LPerezBustos/EC3883_AutomaticGuidedVehicle/final-report/images/3_front.jpg

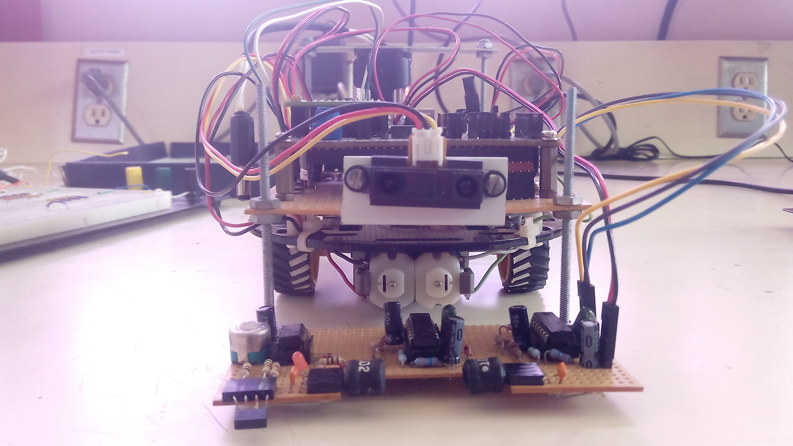
final-report/images/3_front.jpg
