LPerezBustos/EC3883_AutomaticGuidedVehicle/final-report/images/4_side.jpg

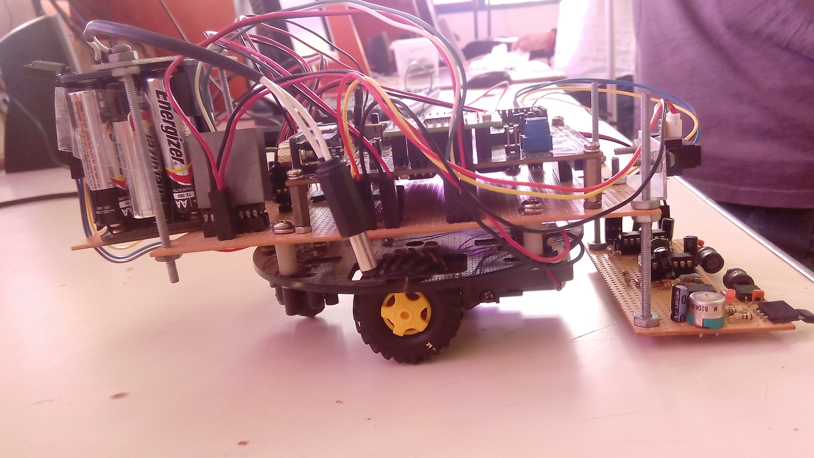
final-report/images/4_side.jpg
