LPerezBustos/EC3883_AutomaticGuidedVehicle/README.md

# Automatic Guided Vehicle for EC3883 coursework
