LPerezBustos/EC3883_AutomaticGuidedVehicle/final-report/Anteproyecto.pdf

# Propuesta de Proyecto - Grupo I Sistema de Vehículo Autónomo con Control de Tráfico

Bernardo Aceituno-C, Alejandro Meilan, Luis Pérez Bustos, Carlos Luis.

## 1. Introducción

Esta propuesta presenta una primera aproximación del proyecto a realizar dentro de la asignatura EC3883. Se dispone de 12 semanas a partir del 09 de enero de 2017 para su realización. Se utilizan principalmente los componentes dispuestos en el Laboratorio C de la Universidad Simón Bolívar más ciertos adicionales adquiridos personalemente. Los Profesores Carlos Morón y Guillermo Villegas se encargarán de monitorear el buen desarrollo del proyecto. Se deben entregar, periodicamente, demostraciones que validen el cumplimiento del plan de trabajo.

## 2. Proyecto

### 2.1. Objetivo General

Realizar vehículo autoguíado (AGV) por detección de señal electromagnética con algortimos de planificación de trayectoria y detección de obstáculos a través de una cámara central.

### 2.2. Objetivos Específicos

1. Configurar funcionamiento de los motores con control PWM a través del driver L293D.
2. Desarrollar circuito de adquisición y acondicionamiento de señal electromagnética para mantener el vehículo en línea recta.
3. Detectar e implementar lógica de toma de decisiones frente a señales de cruce.
4. Detectar obstáculos que se encuentren a cierto rango de distancia e implementar lógica de toma de decisiones.
5. Diseñar algoritmo que controle los movimientos del vehículo a través de una camara web para evitar colisiones con obstáculos u otros vehículos que se encuentren simultáneamente en la cuadrilla.
6. Desarrollar protocolo de comunicación infraroja entre el computador y el vehículo.

### 2.3. Etapas

Para detallar el funcionamiento esperado del proyecto a desarollar se dividió a este en las siguientes etapas.

adquisición y acondicionamiento de señal electromagnética

control PWM de los motores

detección de señal de cruce

detección de obstáculos

mapeado de la cuadrilla

algortimo de planificación

protocolo de comunicación

### 2.4. Representación General

El diagrama de la Figura 1 ilustra el esquema general del proyecto. Se observa el funcionamiento en conjunto de las etapas descritas con anterioridad.

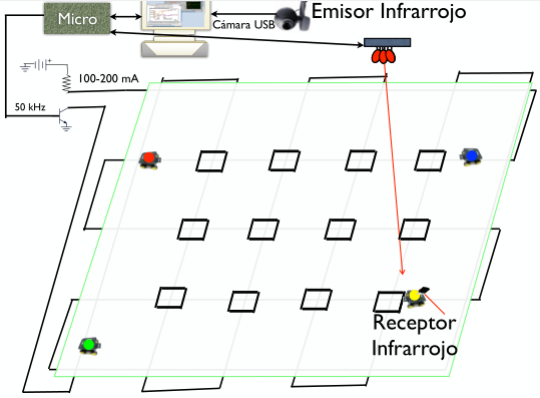
[picture p3: figure]

Figura 1: Esquema general del Proyecto

## 3. Plan de Trabajo:

Se presenta a continuación el plan de trabajo tentativo programado para ser desarrollado a lo largo del trimestre en curso:

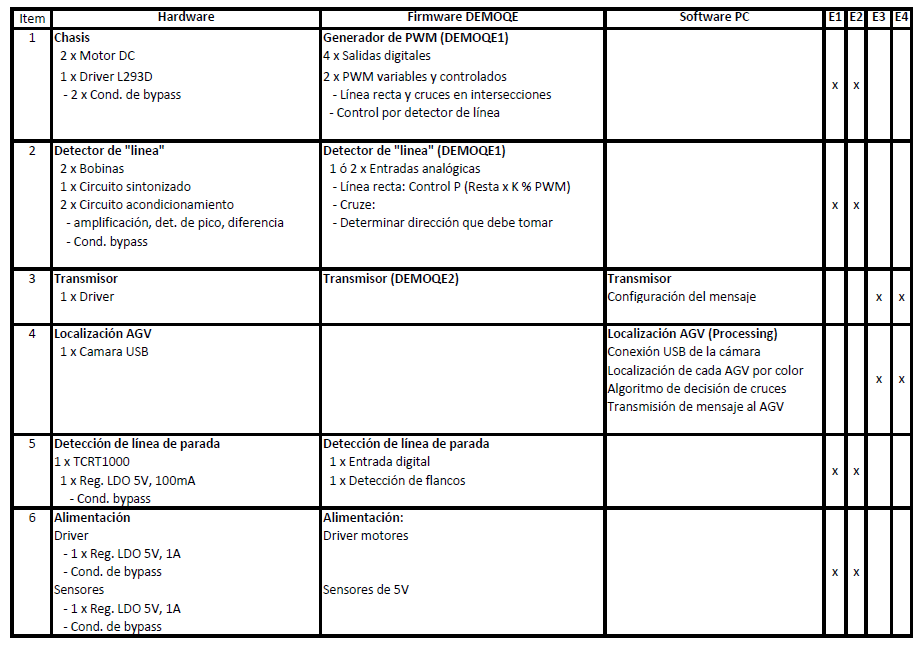
[picture p4: figure]

Figura 2: Distribución de tareas

Tabla 1: Plan de trabajo tentativo
Semana 2 | Revisión bibliográfica y familiari-zación con el entorno de trabajo | Revisión de los circuitos de acon-dicionamiento de señales y dri-vers de sensores
Semana 3 | Diseño e Implementación de sis-tema de detección de vehículos | Montaje en Protoboard del acon-dicionamiento de bobinas, driver de motores, detector de línea y detector de obstáculos
Semana 4 | Pruebas de sistema de detección de vehículos y Mapeo de Pista | Desarrollo del software para ge-neración de señales PWM en ba-se a la señal de las bobinas. Primeras pruebas del sistema de control.
Semana 5 | Pruebas de Mapeo de Pista, Co-municación PC-MCU y Planifi-cacion de Camino y toma de de-cisiones | Incorporación de la detección de línea en algoritmo de contro. Prueba con T para realizar un gi-ro.
Semana 6 | Pruebas de Comunicación, Deci-siones y Planificación, Desarro-llo de Protocolo de Comunica-ción infrarroja | Incorporación de la detección de obstáculos al algoritmo de con-trol.
Semana 7 | Pruebas de Comunicación | Toma de decisiones en base a las señales recibidas desde el PC via IR. Pruebas de comunicación
Semana 8 | Integración con Vehiculo, Imple-mentación de Pista | Soldar circuitos a baquelita y construcción final del carro.
Semana 9 | Pruebas de Funcionamiento de Vehiculo
Semana 10 | Pruebas de Funcionamiento de Vehiculo
Semana 11 | Entrega del proyecto

## 4. Circuitos

A continuación se presentan los circuitos propuestos para el acondimiento de señales y alimentación de distintos tipos de sensores y actuadores.

### 4.1. Fuentes de Voltaje

Se requieren dos fuentes de voltaje para el proyecto: una para alimentar los motores DC del vehículo y una para alimentar el resto de los sensores. Ambas fuentes se presentan en la Figura 3

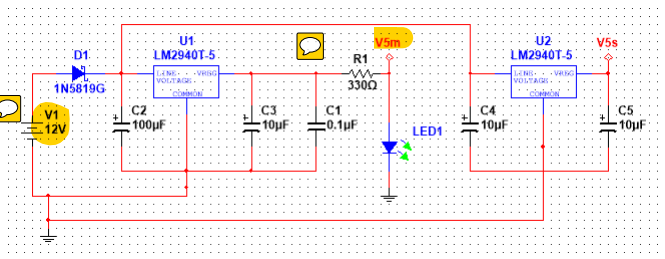
[picture p5: figure]

Figura 3: Fuentes de voltaje DC 5V

La señal V5m corresponde a la alimentación de los motores y la señal V5s a la alimentación de los sensores. En ambos casos se utiliza el integrado LM2940-5 que es un regulador de 5V DC. La entrada de 12V proviene del conector DC del mesón, y se utiliza un diodo rectificador Schottky de protección. En ambas fuentes se utilizan capacitores electrolíticos de bypass, y para la fuente del motor se añade tambien un capacitor cerámico extra para asegurar una alimentación libre de ruido. El LED sirve para verificar en todo momento la correcta alimentación de los motores.

### 4.2. Acondicionamiento de las bobinas

Para este circuito se presentan dos propuestas similares, y a través de simulaciones se determinó cual de ellas era preferible dada la naturaleza del proyecto.

Propuesta 1: el circuito de la Figura 4 es la primera propuesta para acondicionar la señal proveniente de las bobinas.

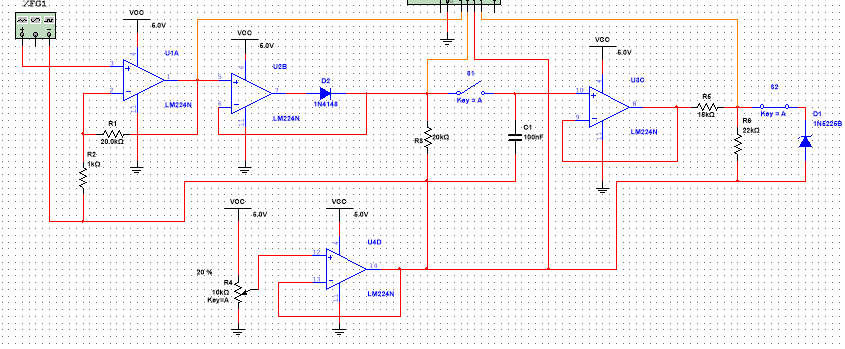
[picture p6: figure]

Figura 4: Acondicionamiento de bobinas - Propuesta 1

Del lado izquierdo hay una primera etapa de amplificación de la señal, con una ganancia de 20 y con una tierra virtual implementada con el seguidor de la parte de abajo, cuya salida de voltaje se maneja con el potenciómetro R4. Seguido de esta etapa de amplificación hay un rectificador de media onda utilizando el diodo 1N4148. La tercera etapa de la adquisición es un detector de pico, para el cual se escogió una combinación de resistencia y capacitor en simulación que otorgara una respuesta adecuada. El buffer de la última etapa se coloca para aislar la salida de las impedancias del resto del circuito, ya que esta salida entrará al microcontrolador. Se coloca un divisor de tensión y un diodo Zener de 3V para proteger al microcontrolador. Los valores del divisor de tensión deberán ser ajustados en práctica dependiendo de las salidas máximas y mínimas de las bobinas.

Se simuló el canal de adquisión con una señal sinusoidal de 50KHz y 50mVp que hiciera las veces de la señal de la bobina. Primero se levantó el switch A para observar la señal del rectificador de media onda (CH2), como se presenta en la Figura 5

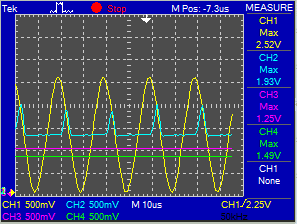
[picture p7: figure]

Figura 5: Amplificador (CH1), Rectificador sin detector de pico (CH2), tierra virtual (CH3), salida final (CH4)

Se observa que la rectificación con un solo diodo no es perfecta, principalmente por las frecuencias a las que se está trabajando. Internamente el diodo presenta retardos respecto a la frecuencia de trabajo de las bobinas que impiden que la rectificación sea mejor. Al bajar el switch se observa en la Figura 6 la respuesta del rectificador con detector de picos en el canal 2.

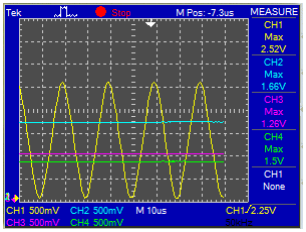
[picture p8: figure]

Figura 6: Amplificador (CH1), Rectificador con detector de pico (CH2), tierra virtual (CH3), salida final (CH4)

Utilizando una tierra virtual de 1.25V, se observa que se levanta el nivel DC de la señal amplificada de la bobina y se elimina la componente negativa de la misma. En el canal 2 se muestra la salida del rectificador con detector de pico, que logra un nivel DC de 1.64V. Finalmente, la señal que entrara al microcontrolador es una DC de 1.48V que es proporcional a la intensidad de campo sobre la bobina.

Propuesta 2: la segunda propuesta para el acondicionamiento de las bobinas se muestra en la Figura 7:

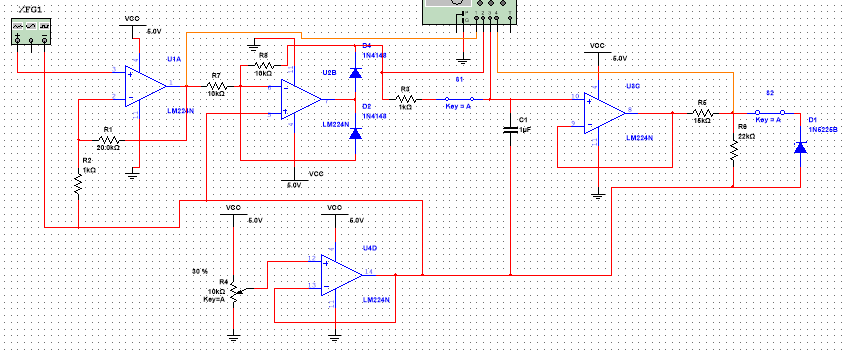
[picture p9: figure]

Figura 7: Acondicionamiento de bobinas - Propuesta 2

La diferencia respecto a la primera propuesta es el circuito rectificador, que en este caso se hace con dos diodos y se trata de de un rectificador de media onda negativa. Después del rectificador se sustituyó el circuito de detección de picos por un filtro pasabajo con frencuencia de corte 1/RC = 1000rad/s = 159,15Hz. Este nuevo circuito de rectificación otorgó mejores resultados que en el caso anterior, como muestra la Figura 8:

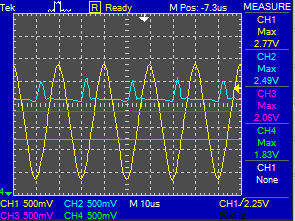
[picture p10: figure]

Figura 8: Amplificador (CH1), Rectificador (CH2), Filtro pasabajo (CH3), Salida final (CH4)

La señal del canal 2 muestra la salida del rectificador, que al compararla con la señal obtenida con la primera propuesta se nota que presenta una respuesta más adecuada, con menos retardos en la señal rectificada. El valor de voltaje de la salida del canal de adquisición es mayor gracias a la rectificación mejorada, por lo que esta propuesta es la que se implementará en el proyecto.

### 4.3. Driver de los motores

Para controlar los motores se utilizan señales PWM, utilizando el driver de motores L293D, tal como se muestra en la Figura 9:

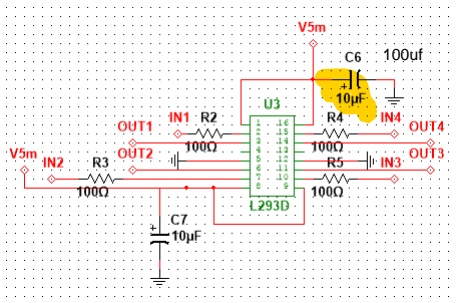
[picture p11: figure]

Figura 9: Driver de motores

Las entradas INx van al microcontrolador, a partir del cual se envian 1s y 0s lógicos para crear las señales cuadradas del PWM. Las salidas OUTx irán conectadas a los motores. El control del ancho de pulso se hace también desde el microcontrolador y será la salida del controlador a implementar para que el vehículo siga la línea, según las lecturas de las bobinas.

### 4.4. Detección de Obstáculos

Con el objetivo de detectar objetos que obstruyan el camino de vehículo autoguíado, se utiliza el sensor de distancia por emisión infraroja Sharp GP2Y0A21YK. El objetivo es incorporar una nueva primititiva que permita al vehículo tomar decisiones adecuadas de acuerdo a su entorno. La Figura 10 muestra el modelo comercial del cual se dispone en el laboratorio C. Las características eléctricas del dispositivo se listan a continuación:

Vcc: 4,5V a +5,5V

Rango de distancias: 10cm a 80cm

Vo @ L=80cm: 0,25V a 0,55V

Icc @ L=80cm: 30mA a 40mA

Vo(@L=10cm) - Vo(@L=80cm): 1,65V a 2,15V

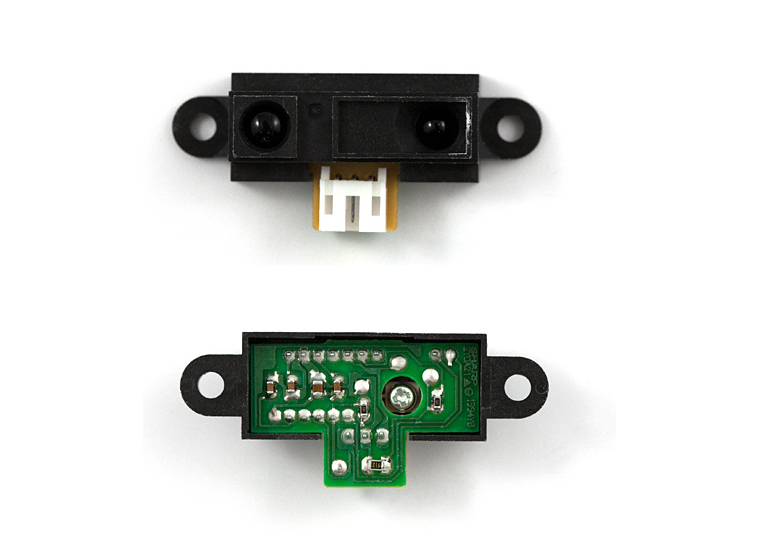
[picture p12: figure]

Figura 10: Sensor de proximidad Sharp GP2Y0A21YK

La Figura 11 ilustra la respuesta del sensor en su rango de funcionamiento correspondiente. Se observa un máximo entre 5cm y 10cm con una respuesta aproximadamente lineal hasta 30cm.

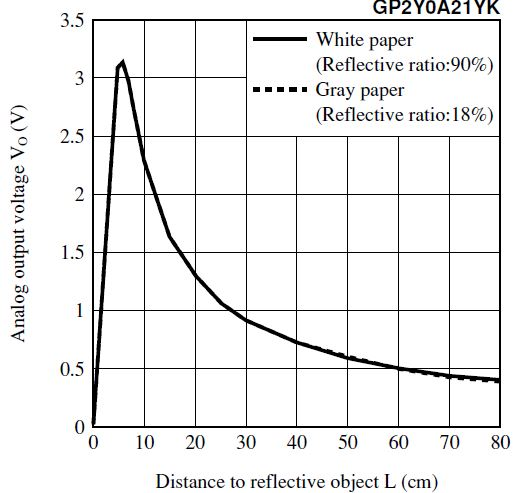
[picture p13: figure]

Figura 11: Relación Vo (V) vs. distancia (cm)

El funcionamiento del sensor GP2Y0A21YK se observa en la Figura 12. El detector infrarojo situado a la derecha del sensor recibe la señal reflejada desde una cierta superficie y enfocada a través del lente. El circuito interno del sensor permite arrojar una señal que sigue el patrón de la Figura 11.

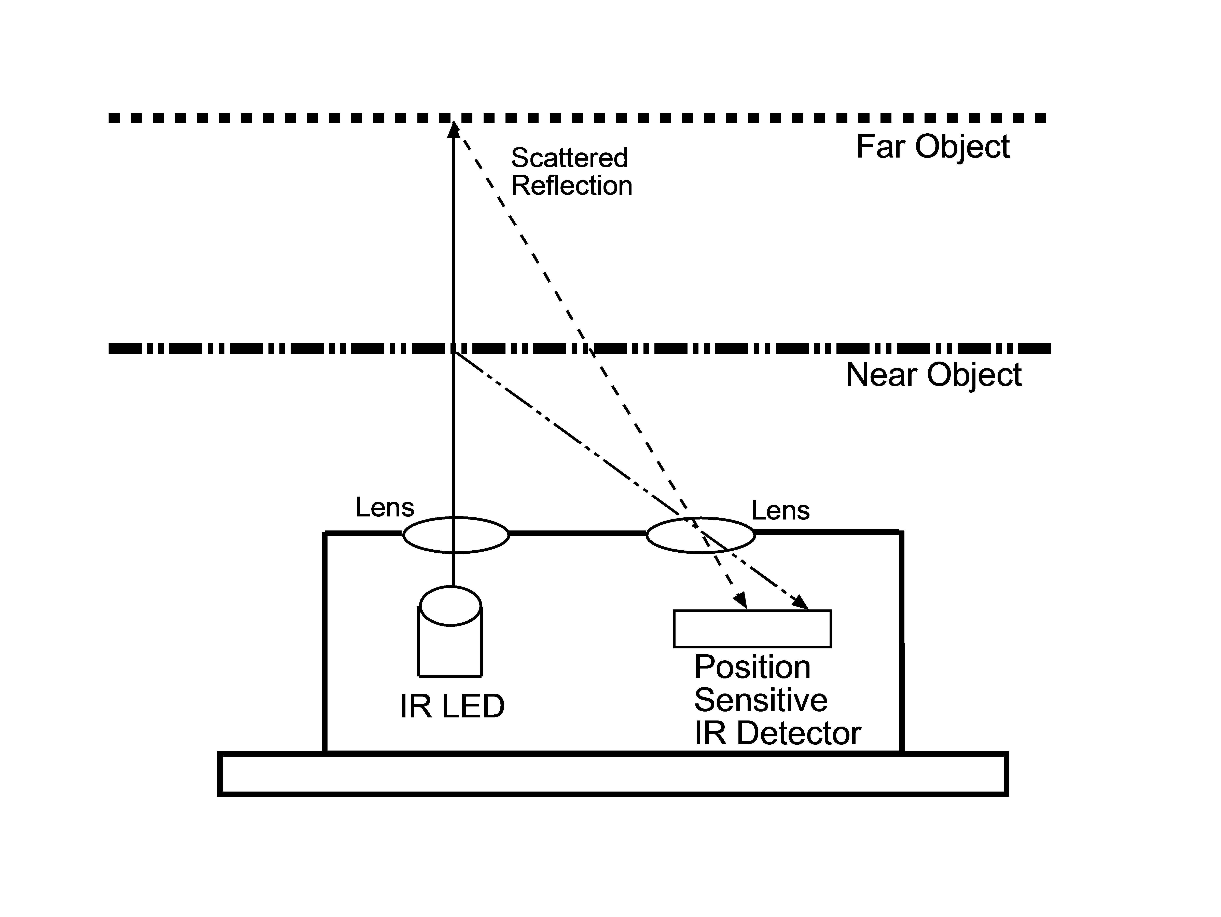
[picture p14: figure]

Figura 12: Funcionamiento del sensor de proximidad

Para adquirir la señal deseada desde el demoQE128, se acondiciona la señal utilizando el circuito de la Figura 13. Se utiliza la segunda etapa del circuito para reducir el nivel de voltaje en un 60 % y evitar máximos que sobrepasen los límites del micro-controlador.

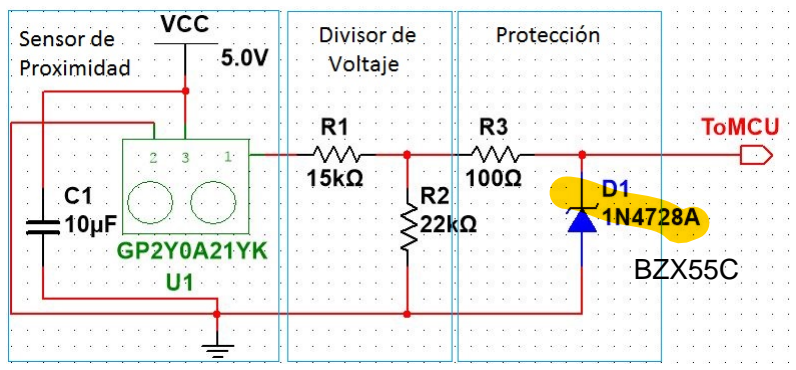
[picture p15: figure]

Figura 13: Circuito de adquisición y acondicionamiento

### 4.5. Detección de Señal de Cruce

A la lógica del vehículo autoguíado se añade la detección de señales de cruce colocadas en las intersecciones de la cuadrilla. Se han de fijar marcas oscuras en dichos lugares. Para su adecuada detección se utiliza el sensor óptico TCRT1000 de la Figura 14. Es un sensor reflectivo que incluye un emisor infrarojo y un fototransistor en un mismo empaquetado sellado que bloquea la luz visible.

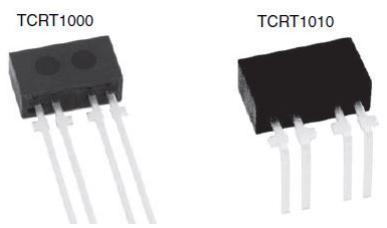
[picture p16: figure]

Figura 14: Sensor óptico TCRT1000

Las dimensiones del módulo se observan en la Figura 15.

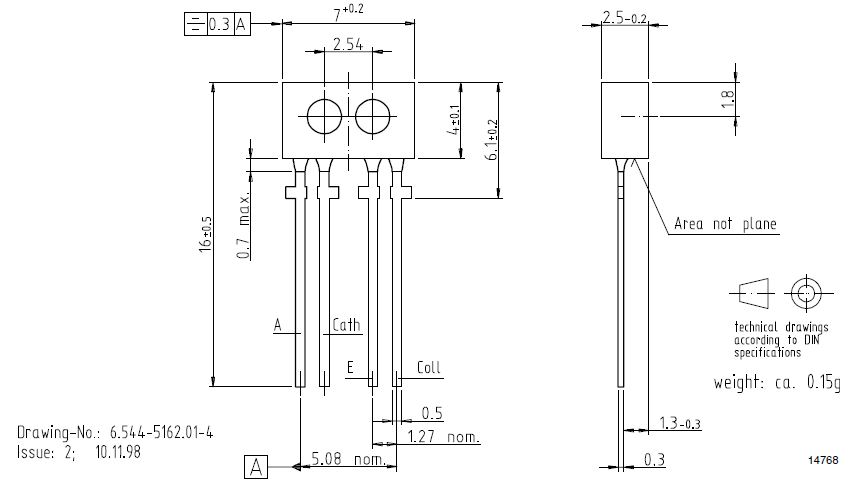
[picture p17: figure]

Figura 15: Dimensiones del sensor óptico TCRT1000

El emisor genera luz infraroja de hasta 940nm que es reflejada (o no) por la superficie correspondiente. La salida detecta esta luz y se habilita (o no) el paso de corriente de colector a emisor. La Figura 16 ilustra el funcionamiento.

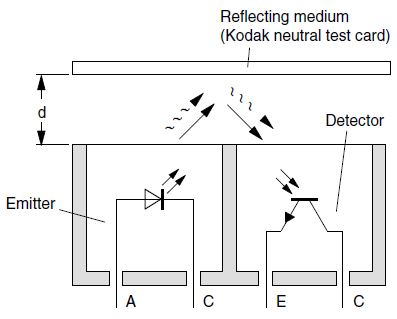
[picture p18: figure]

Figura 16: Funcionamiento del sensor óptico

Se añade el circuito de acondicionamiento de la Figura 17. La salida del TCRT1000 es a través de una resistencia pull-up que se conecta directamente al comparador LM311. La salida de este módulo depende de la diferencia de voltajes entre los pines 2 y 3. En la entrada inversora se fija un cierto voltaje de threshold con el cual se comparará la señal de la entrada no-inversora. Los niveles de tensión posibles estarán entre el %60 de Vcc ( 3V) y el voltaje fijado en el pin 1 (GND). Se añade una etapa de protección como parte final del circuito.

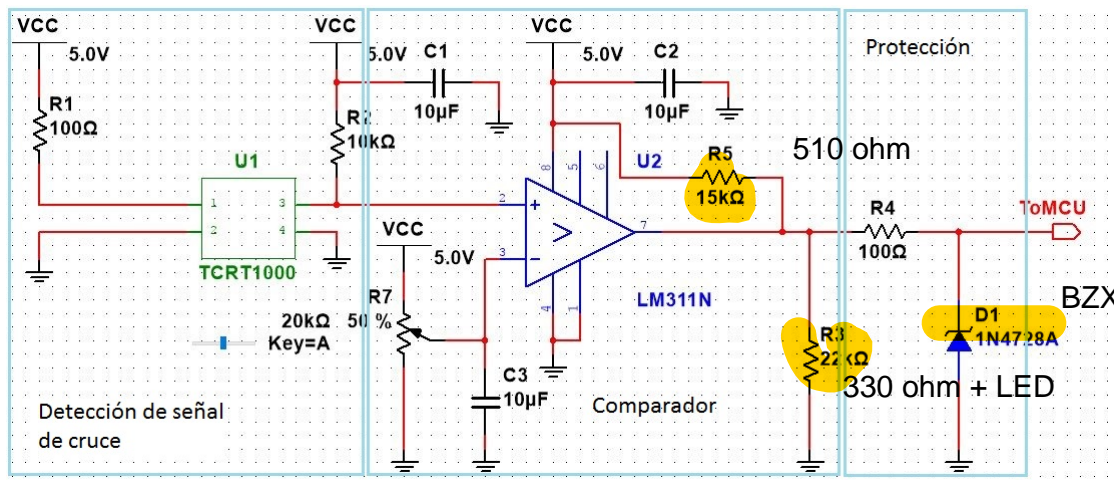
[picture p19: figure]

Figura 17: Circuito de adquisición y acondicionamiento

### 4.6. Circuito Seguidor de Línea

Esta configuración será utilizada para acondicionar la línea de pista por la cual se desplazará el vehiculo. Consiste básicamente en obtener una señal desde el microcontrolador (onda cuadrada de 3V @50kHz) y pasarlo por un circuito emisor común. De esta forma la señal que debe seguir el carro a través de la bobinas estará correctamente acondicionada. Un esquematico del circuito es mostrado en la Figura 18.

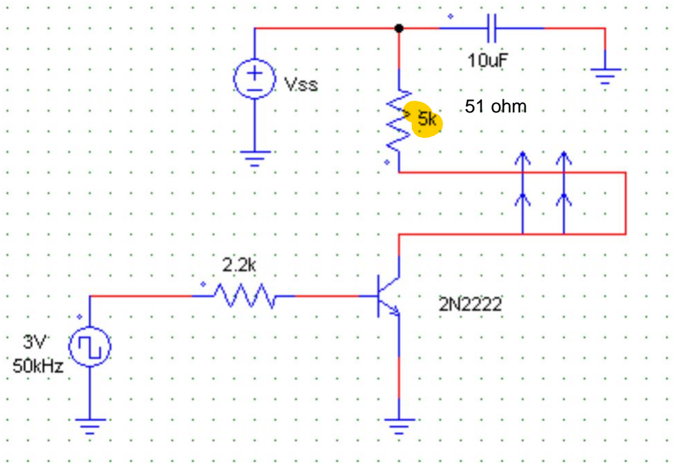
[picture p20: figure]

Figura 18: circuito Seguidor de Línea

### 4.7. Circuito Transmisión Infrarroja – Vehiculo / Mesón

Estas dos configuraciones son necesarias para acondicionar la transmisión infrarroja entre el carrito y el mesón. La primera consiste en un TSOP1136 protegido con un diodo zener de 3 voltios y una resistencia. El segundo es un circuito emisor común con un capacitor y un diodo en inverso. Ambas configuraciones son necesarias para la transmisión infrarroja entre los dispositivos. Estos circuitos mostrados en las figuras Figura 19 y Figura 20.

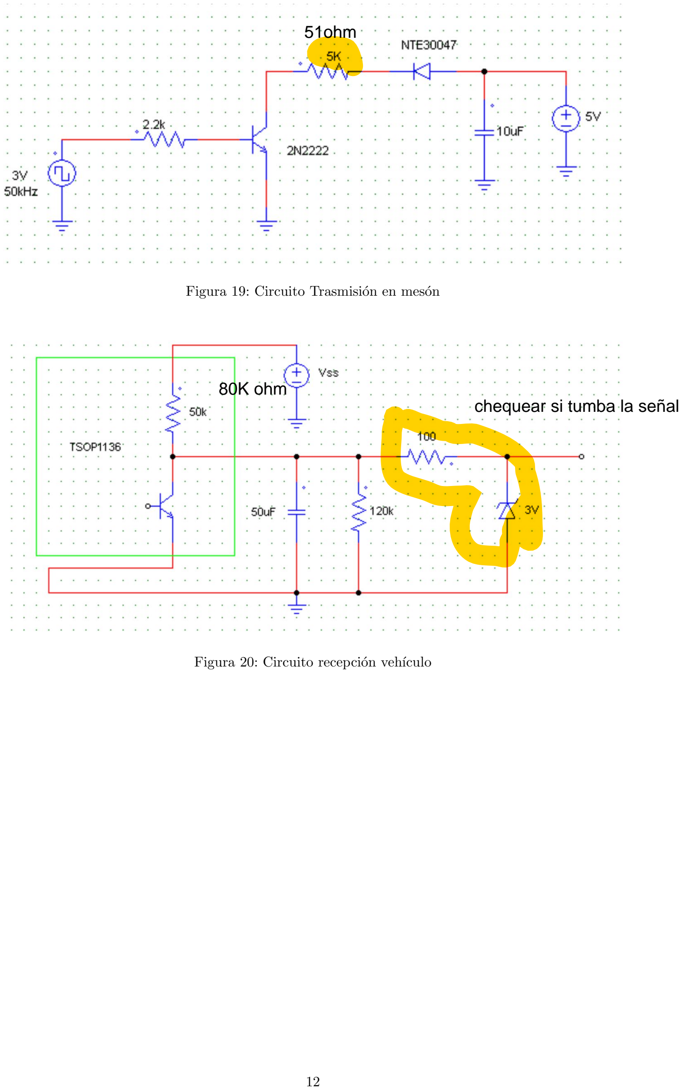
[picture p21: page 12]

Figura 19: Circuito Trasmisión en mesón

Figura 20: Circuito recepción vehículo

## 5. Arquitectura Software

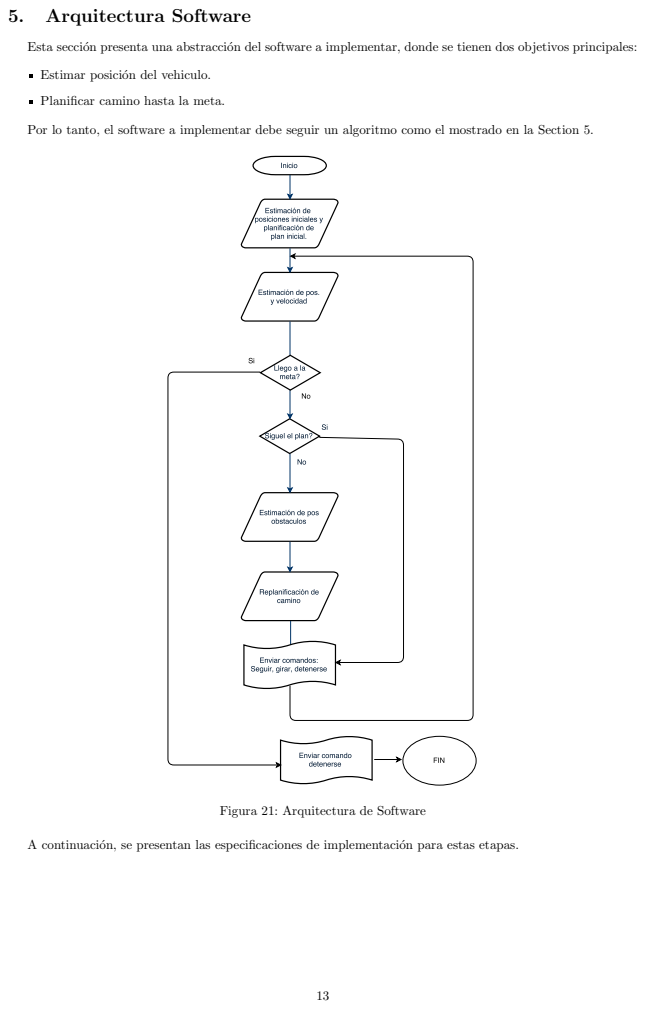
[picture p22: page 13]

Esta sección presenta una abstracción del software a implementar, donde se tienen dos objetivos principales:

Estimar posición del vehiculo.

Planificar camino hasta la meta.

Por lo tanto, el software a implementar debe seguir un algoritmo como el mostrado en la Section 5.

Figura 21: Arquitectura de Software

A continuación, se presentan las especificaciones de implementación para estas etapas.

### 5.1. Visión

La etapa de visión poro computadora será desarrollada en Python 3.5.0 bajo la librería OpenCV 3, dicha librería ofrece las siguientes funcionalidades de interés:

1. Interfaz con camara de video.
2. Extracción de fondo de imagen.
3. Estimación de posición de objetos.

En particular resultan de interes las funciones presentadas en la tabla Tabla 2

Tabla 2: Funciones de interés para la etapa de visión
inRange | Extrae los pixeles en un color de la imagen dada
erode | Elimina residuos de la extraccion de mascara del objeto
dilate | Dilata la mascara obtenida para reducción de ruido
findContours | calcula el contorno de las formas presentes en la máscara
minEnclosingCircle | Obtiene el radio y el centro del circulo presente en la máscara

### 5.2. Planificación

La planificación a implementar será basada en teoria de grafos, sobre una versión discretizada del espacio de trabajo. Para ello se va a implementar una libreria de grafos sobre Python 3.0 con los siguientes objetivos:

1. Representación de caminos unidireccionales y bidireccionales.
2. Representación de heuristicas admisibles basadas en distancia.
3. Inhabilitación de caminos.
4. planificación de caminos basada en busquedas discretas con heuristica.

Esta ultima etapa resulta de mayor interés para este proyecto, pues debe ser capaz de calcular el cámino mas corto entre dos puntos dados. Para esto resulta de interés el uso del algoritmo de busqueda A*, pues resulta en planes optimos con poca exigencia computacional, como se muestara en la Section 5.2

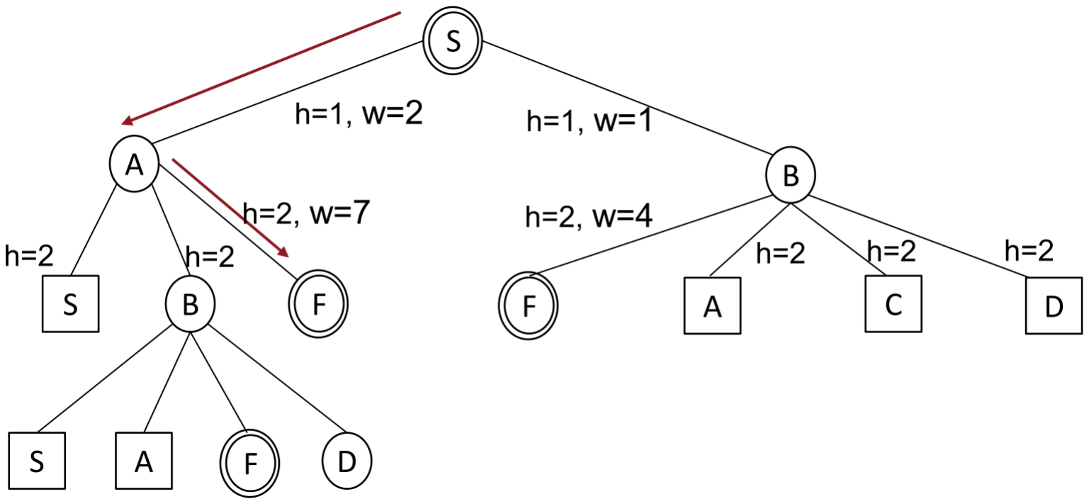
[picture p23: figure]

Figura 22: Interpretación gráfica del algoritmo A*

### 5.3. Comunicación

La comunicación con el microcontrolador se realizara mediante protocolo serial, para ello se puede hacer uso de la libreria serial incluida en Python 3.0 con un protocolo de comunicación binario de instrucciones simples.
