LPerezBustos/EC3883_AutomaticGuidedVehicle/final-report/Informe-Final-EC3883.pdf

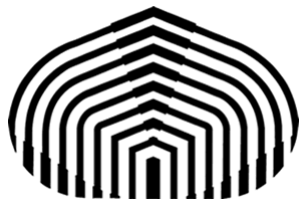
[picture p24: figure]

# Informe de Proyecto Sistema de Vehículo Autoguiado (AGV) con Control de Tráfico

Bernardo Aceituno-C, Alejandro Meilan, Luis Pérez Bustos, Carlos Luis.

## Índice

1. Introducción | 3
2. Estructura del Proyecto | 4
3. Hardware | 5
4. Software | 17

## 1. Introducción

El proyecto asociado a la asignatura EC3883 “Laboratorio de Proyectos III” corresponde a un trabajo grupal que engloba diversas áreas de la electrónica como circuitos analógicos, sistemas embebidos, control y comunicaciones.

El proyecto consiste en diseñar un vehículo autónoma con capacidades de seguimientos de una línea eléctrica y con componentes adicionales de seguridad como detección de líneas de paradas, detección de obstáculos y un controlador de alto nivel que le indica una ruta para llegar a un punto deseado.

En este documento se incluye información concisa sobre la primera propuesta inicial así como detalles de la implementación final del proyecto, con diagramas e imágenes para facilitar su entendimiento al igual que evidencia videográfica de su funcionamiento.

## 2. Estructura del Proyecto

Esta sección presenta una visión general del funcionamiento y la implementación del proyecto.

### 2.1. Objetivo General

Realizar vehículo autoguíado (AGV) por detección de señal electromagnética con algortimos de planificación de trayectoria y detección de obstáculos a través de una cámara central.

### 2.2. Objetivos Específicos

1. Configurar funcionamiento de los motores con control PWM a través del driver L293D.
2. Desarrollar circuito de adquisición y acondicionamiento de señal electromagnética para mantener el vehículo en línea recta.
3. Detectar e implementar lógica de toma de decisiones frente a señales de cruce.
4. Detectar obstáculos que se encuentren a cierto rango de distancia e implementar lógica de toma de decisiones.
5. Diseñar algoritmo que controle los movimientos del vehículo a través de una camara web para evitar colisiones con obstáculos u otros vehículos que se encuentren simultáneamente en la cuadrilla.
6. Desarrollar protocolo de comunicación infraroja entre el computador y el vehículo.

### 2.3. Etapas

Para detallar el funcionamiento esperado del proyecto a desarollar se dividió a este en las siguientes etapas.

1. adquisición y acondicionamiento de señal electromagnética
2. control PWM de los motores
3. detección de señal de cruce
4. mapeado de la cuadrilla
5. algortimo de planificación
6. protocolo de comunicación

### 2.4. Representación General

El diagrama de la Figura 1 ilustra el esquema general del proyecto. Se observa el funcionamiento en conjunto de las etapas descritas con anterioridad.


Figura 1: Esquema general del Proyecto

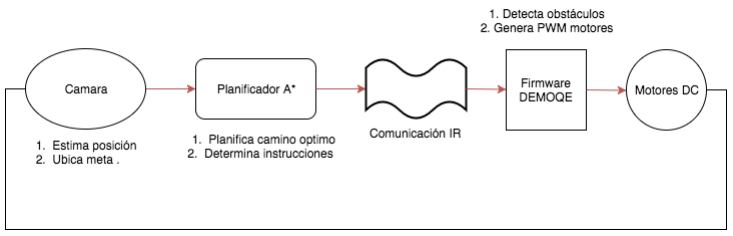
[picture p25: figure]

Figura 2: Diagrama de fucionamiento del sistema

## 3. Hardware

A continuación se presentan los circuitos utilizados para el acondimiento de señales y alimentación de los sensores y actuadores utilizados.

### 3.1. Fuentes de Voltaje

Se utilizaron dos fuentes de voltaje para el proyecto: una para alimentar los motores DC del vehículo y una para alimentar el resto de los sensores. Ambas fuentes se presentan en la Figura 3

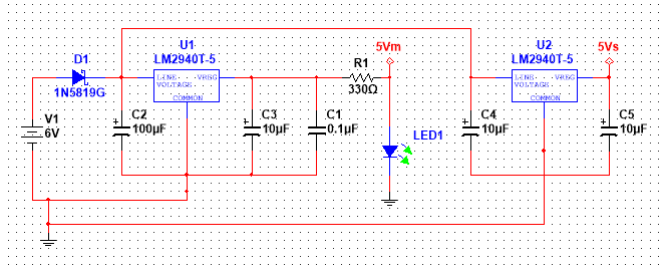
[picture p26: figure]

Figura 3: Fuentes de voltaje DC 5V

La señal V5m corresponde a la alimentación de los motores y la señal V5s a la alimentación de los sensores. En ambos casos se utiliza el integrado LM2940-5 que es un regulador de 5V DC. La entrada de 12V proviene del conector DC del mesón, y se utiliza un diodo rectificador Schottky de protección. En ambas fuentes se utilizan capacitores electrolíticos de bypass, y para la fuente del motor se añade tambien un capacitor cerámico extra para asegurar una alimentación libre de ruido. El LED sirve para verificar en todo momento la correcta alimentación de los motores.

### 3.2. Acondicionamiento de las bobinas

Para este circuito se presentan dos propuestas similares, y a través de simulaciones se determinó cual de ellas era preferible dada la naturaleza del proyecto.

Propuesta 1: el circuito de la Figura 4 es la primera propuesta para acondicionar la señal proveniente de las bobinas.


Figura 4: Acondicionamiento de bobinas - Propuesta 1

Del lado izquierdo hay una primera etapa de amplificación de la señal, con una ganancia de 20 y con una tierra virtual implementada con el seguidor de la parte de abajo, cuya salida de voltaje se maneja con el potenciómetro R4. Seguido de esta etapa de amplificación hay un rectificador de media onda utilizando el diodo 1N4148. La tercera etapa de la adquisición es un detector de pico, para el cual se escogió una combinación de resistencia y capacitor en simulación que otorgara una respuesta adecuada. El buffer de la última etapa se coloca para aislar la salida de las impedancias del resto del circuito, ya que esta salida entrará al microcontrolador. Se coloca un divisor de tensión y un diodo Zener de 3V para proteger al microcontrolador. Los valores del divisor de tensión deberán ser ajustados en práctica dependiendo de las salidas máximas y mínimas de las bobinas.

Se simuló el canal de adquisión con una señal sinusoidal de 50KHz y 50mVp que hiciera las veces de la señal de la bobina. Primero se levantó el switch A para observar la señal del rectificador de media onda (CH2), como se presenta en la Figura 5


Figura 5: Amplificador (CH1), Rectificador sin detector de pico (CH2), tierra virtual (CH3), salida final (CH4)

Se observa que la rectificación con un solo diodo no es perfecta, principalmente por las frecuencias a las que se está trabajando. Internamente el diodo presenta retardos respecto a la frecuencia de trabajo de las bobinas que impiden que la rectificación sea mejor. Al bajar el switch se observa en la Figura 6 la respuesta del rectificador con detector de picos en el canal 2.


Figura 6: Amplificador (CH1), Rectificador con detector de pico (CH2), tierra virtual (CH3), salida final (CH4)

Utilizando una tierra virtual de 1.25V, se observa que se levanta el nivel DC de la señal amplificada de la bobina y se elimina la componente negativa de la misma. En el canal 2 se muestra la salida del rectificador con detector de pico, que logra un nivel DC de 1.64V. Finalmente, la señal que entrara al microcontrolador es una DC de 1.48V que es proporcional a la intensidad de campo sobre la bobina.

Propuesta 2: la segunda propuesta para el acondicionamiento de las bobinas se muestra en la Figura 7:


Figura 7: Acondicionamiento de bobinas - Propuesta 2

La diferencia respecto a la primera propuesta es el circuito rectificador, que en este caso se hace con dos diodos y se trata de un rectificador de media onda negativa. Después del rectificador se sustituyó el circuito de detección de picos por un filtro pasabajo con frencuencia de corte 1/RC = 1000rad/s = 159,15Hz. Este nuevo circuito de rectificación otorgó mejores resultados que en el caso anterior, como muestra la Figura 8:

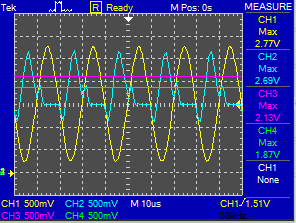
[picture p27: figure]

Figura 8: Amplificador (CH1), Rectificador (CH2), Filtro pasabajo (CH3), Salida final (CH4)

La señal del canal 2 muestra la salida del rectificador, que al compararla con la señal obtenida con la primera propuesta se nota que presenta una respuesta más adecuada, con menos retardos en la señal rectificada. El valor de voltaje de la salida del canal de adquisición es mayor gracias a la rectificación mejorada, por lo que esta propuesta es la que se implementará en el proyecto.

El circuito final implementado es el mostrado en la Figura 9

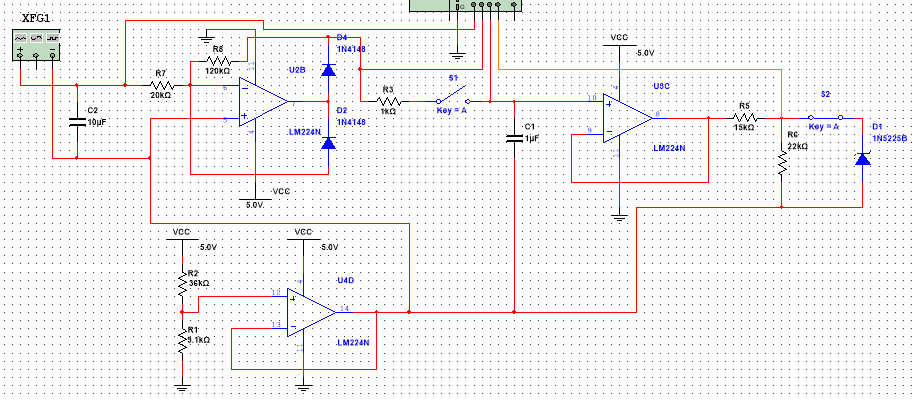
[picture p28: figure]

Figura 9: Circuito final para adquisión de señal de bobinas

Los principales cambios introducidos en la versión final es la eliminación de uno de los operacionales para realizar la etapa de rectificación y amplificación con un sólo opamp, además de reducir la ganancia de 20 a 6 para obtener una máxima excursión en la señal DC obtenida a través del circuito de acondicionamiento. Se sustituyó el potenciómetro que fijaba la tierra virtual por una combinación de resistencias que dio un offset DC de 1V (usando 9.1k y 36k).

La primera acción al montar el circuito fue determinar la frecuencia de resonancia de las bobinas utilizadas, es decir, la frecuencia en la que la amplitud de la onda sinusoidal era máxima, que resultó ser de 56KHz y fue la frecuencia utilizada para excitar estos sensores (utilizando el cable de la pista). Con este circuito se hicieron mediciones con dos casos especiales: la bobina está lejos de la pista, y la bobina está justo encima de la línea elećtrica. En el primero de los casos la salida del circuito de acondicionamiento era directamente el nivel DC de la tierra virtual del sistema (1V), mientras que al estar encima de la línea el voltaje arrojado por la bobina era el máximo posible que resultó ser de 2.88V. Estos datos fueron importantes a la hora de codificar el firmware de control de los motores pues permitía saber a groso modo en qué punto el carro estaba pasando sobre una de las líneas al realizar un giro.

### 3.3. Driver de los motores

Para controlar los motores se utilizan señales PWM, utilizando el driver de motores L293D, tal como se muestra en la Figura 10:

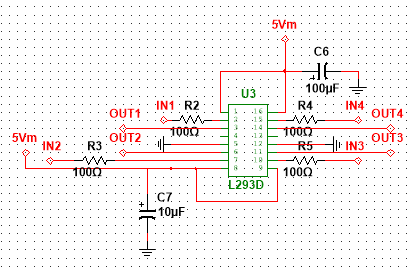
[picture p29: figure]

Figura 10: Driver de motores

Las entradas INx van al microcontrolador, a partir del cual se envian 1s y 0s lógicos para crear las señales cuadradas del PWM. Las salidas OUTx irán conectadas a los motores. El control del ancho de pulso se hace también desde el microcontrolador y será la salida del controlador a implementar para que el vehículo siga la línea, según las lecturas de las bobinas.

### 3.4. Detección de Obstáculos

Con el objetivo de detectar objetos que obstruyan el camino del vehículo autoguíado, se utilizó el sensor de distancia por emisión infraroja Sharp GP2Y0A21YK. El objetivo fue incorporar una nueva primititiva que permitiera al vehículo tomar decisiones adecuadas de acuerdo a su entorno. La Figura 11 muestra el mode-lo comercial del cual se dispone en el laboratorio C. Las características eléctricas del dispositivo se listan a continuación:

Vcc: 4,5V a +5,5V

Rango de distancias: 10cm a 80cm

Vo @ L=80cm: 0,25V a 0,55V

Icc @ L=80cm: 30mA a 40mA

Vo(@L=10cm) - Vo(@L=80cm): 1,65V a 2,15V


Figura 11: Sensor de proximidad Sharp GP2Y0A21YK

La Figura 12 ilustra la respuesta del sensor en su rango de funcionamiento correspondiente. Se observa un máximo entre 5cm y 10cm con una respuesta aproximadamente lineal hasta 30cm.


Figura 12: Relación Vo (V) vs. distancia (cm)

El funcionamiento del sensor GP2Y0A21YK se observa en la Figura 13. El detector infrarojo situado a la derecha del sensor recibe la señal reflejada desde una cierta superficie y enfocada a través del lente. El circuito interno del sensor permite arrojar una señal que sigue el patrón de la Figura 12.


Figura 13: Funcionamiento del sensor de proximidad

Para adquirir la señal deseada desde el demoQE128, se acondicionó la señal utilizando el circuito de la Figura 14. Se utilizó la segunda etapa del circuito para reducir el nivel de voltaje en un 60 % y evitar máximos que sobrepasen los límites del micro-controlador.

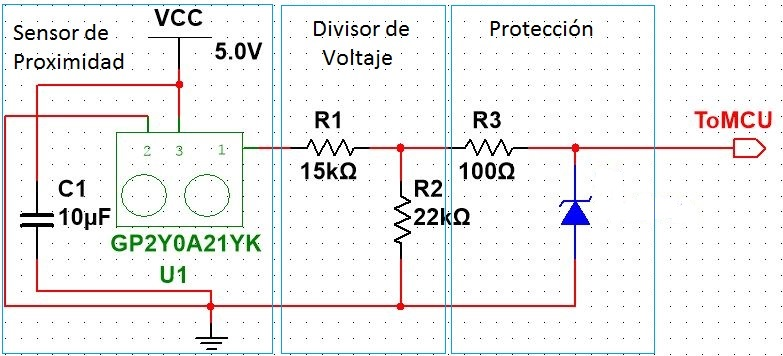
[picture p30: figure]

Figura 14: Circuito de adquisición y acondicionamiento

Experimentalmente se midieron los voltajes a la salida del circuito de adquisición para tener una idea de qué limite utilizar dentro del firmware para determinar que un obstáculo estaba efectivamente presente frente al vehículo. De este modo se podía ajustar con un sólo parámetro qué tan lejos se podían detectar los obstáculos, respetando los límites del sensor.

### 3.5. Detección de Señal de Cruce

A la lógica del vehículo autoguíado se añadió la detección de señales de cruce colocadas en las intersecciones de la cuadrilla. En la pista de pruebas existían marcas oscuras en dichos lugares. Para su adecuada detección se utilizó el sensor óptico TCRT1000 de la Figura 15. Es un sensor reflectivo que incluye un emisor infrarojo y un fototransistor en un mismo empaquetado sellado que bloquea la luz visible.


Figura 15: Sensor óptico TCRT1000

Las dimensiones del módulo se observan en la Figura 16.


Figura 16: Dimensiones del sensor óptico TCRT1000

El emisor genera luz infraroja de hasta 940nm que es reflejada (o no) por la superficie correspondiente. La salida detecta esta luz y se habilita (o no) el paso de corriente de colector a emisor. La Figura 17 ilustra el funcionamiento.


Figura 17: Funcionamiento del sensor óptico

Se añadió el circuito de acondicionamiento de la Figura 18. La salida del TCRT1000 es a través de una resistencia pull-up que se conecta directamente al comparador LM311. La salida de este módulo depende de la diferencia de voltajes entre los pines 2 y 3. En la entrada inversora se fija un cierto voltaje de threshold con el cual se comparará la señal de la entrada no-inversora. Los niveles de tensión posibles estarán entre el %60 de Vcc ( 3V) y el voltaje fijado en el pin 1 (GND). Al final se agregó una etapa de protección como parte final del circuito.

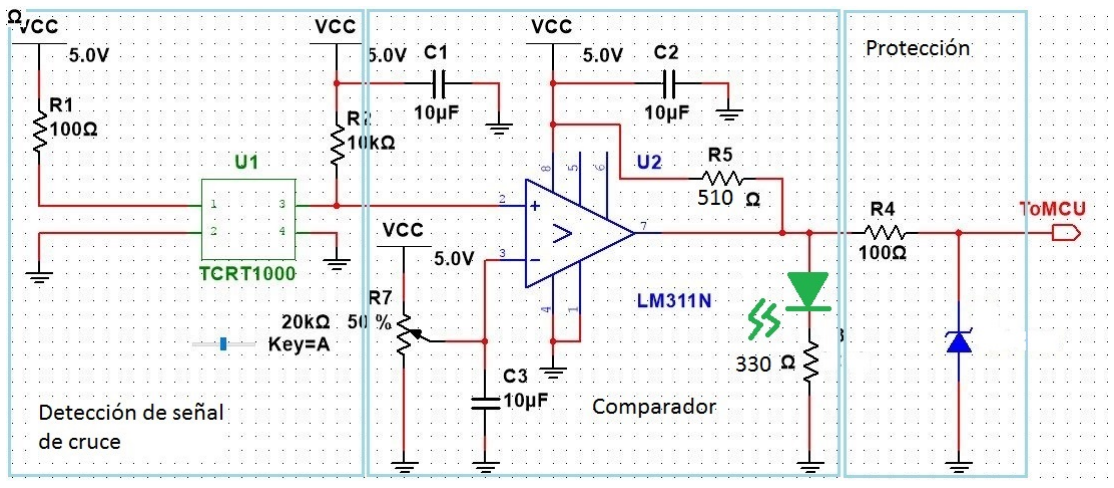
[picture p31: figure]

Figura 18: Circuito de adquisición y acondicionamiento

Experimentalmente lo más complicado de este circuito fue calibrar el potenciómetro para lograr, en primer lugar, detectar correctamente las líneas de parada en la pista, y en segundo lugar, evitar que el circuito arrojara falsos positivos dadas las vibraciones del carro o irregularidades en la pista. Esta parte fue esencial para el correcto funcionamiento del código embebido, puesto que éste dependía fuertemente de la detección de líneas para la realización oportuna de las rutas pedidas (cruzar hacia la derecha, izquierda, o seguir recto)

### 3.6. Circuito Seguidor de Línea

Esta configuración fue utilizada para acondicionar la línea de pista por la cual se desplazará el vehiculo. Consiste básicamente en obtener una señal desde el microcontrolador (onda cuadrada de 3V @56kHz) y pasarlo por un circuito emisor común. De esta forma la señal que debe seguir el carro a través de la bobinas estará correctamente acondicionada. Un esquematico del circuito es mostrado en la Figura 19.

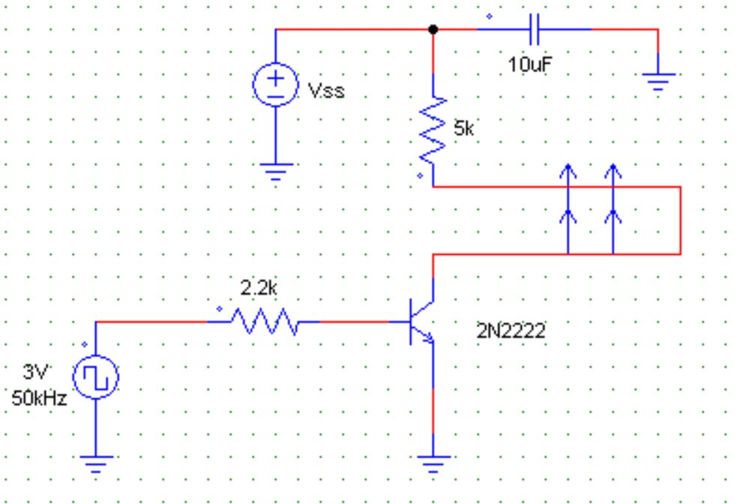
[picture p32: figure]

Figura 19: circuito Seguidor de Línea

### 3.7. Circuito Transmisión Infrarroja – Vehiculo / Mesón

Estas dos configuraciones son necesarias para acondicionar la transmisión infrarroja entre el carrito y el mesón. La primera consiste en un TSOP1136 protegido con un diodo zener de 3 voltios y una resistencia. El segundo es un circuito emisor común con un capacitor y un diodo en inverso. Ambas configuraciones son necesarias para la transmisión infrarroja entre los dispositivos. Estos circuitos mostrados en las figuras Figura 20 y Figura 21.

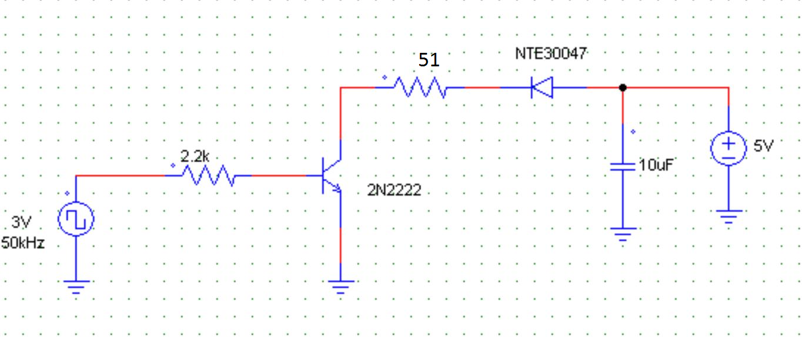
[picture p33: figure]

Figura 20: Circuito Trasmisión en mesón

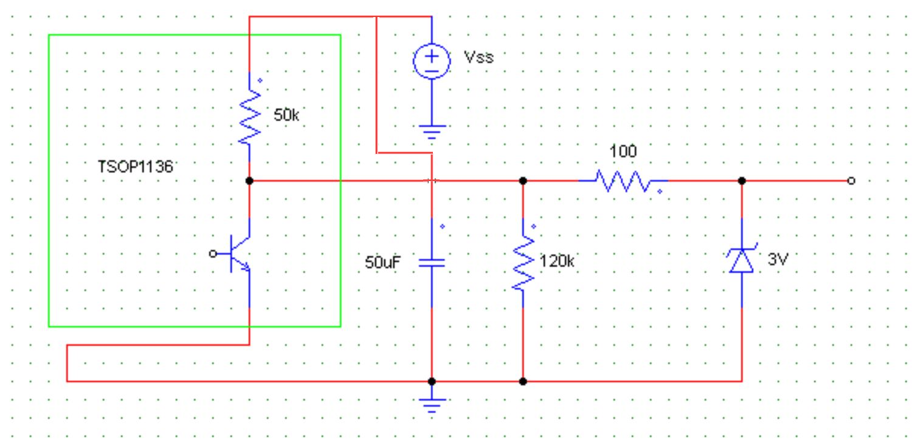
[picture p34: figure]

Figura 21: Circuito recepción vehículo

### 3.8. Montaje final

Una vez probados todos los circuitos en Protoboard, se procedió a soldarlos en baquelita para la construcción final del vehículo. Se utilizaron dos baquelitas:

Baquelita de bobinas: esta baquelita iba rozando el piso y en ella se incluyeron los circuitos de ambas bobinas al igual que el circuito de detección de línea de parada, como muestra en la Figura 22. Fue de suma importancia fijar con fuerza esta baquelita al cuerpo del vehículo para minimizar las vibraciones y movimientos, que podían conllevar a falsos positivos del detector de línea de parada, lo que finalmente incurría en una mala ejecución de las rutas propuestas. La distancia entre el suelo y la baquelita fue tal que no rozara con la pista, pero que fuera lo suficientemente baja para que detectara correctamente las líneas de parada.

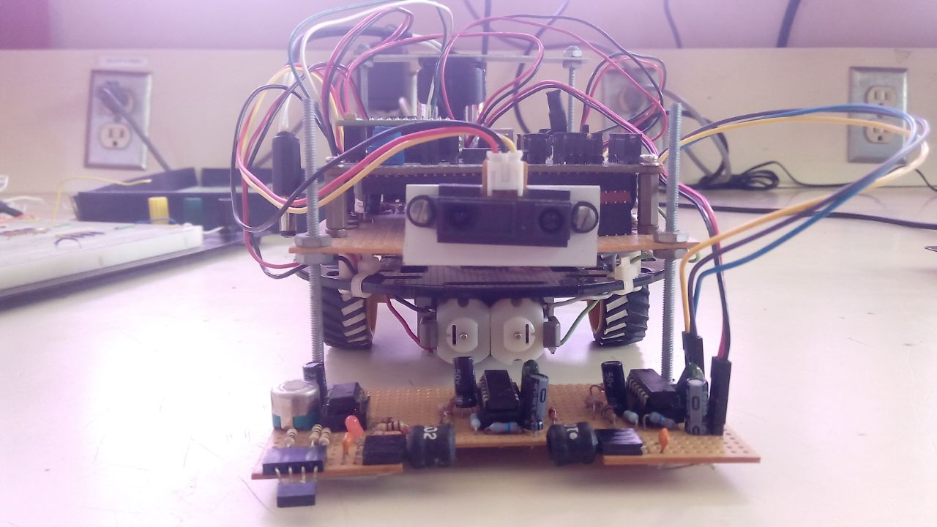
[picture p35: figure]

Figura 22: Baquelita de bobinas y detección de línea de parada.

Baquelita del microcontrolador: esta baquelita constituyó el cuerpo del vehículo autónomo. Sobre ella reposó el demoQE128, al igual que los circuitos correspondientes a los drivers de motores, detector Sharp, detector de infrarrojo TSOP, fuentes de alimentación y todo el cableado hacia el microcontrolador. Una vista de esta baquelita se muestra en la Figura 23

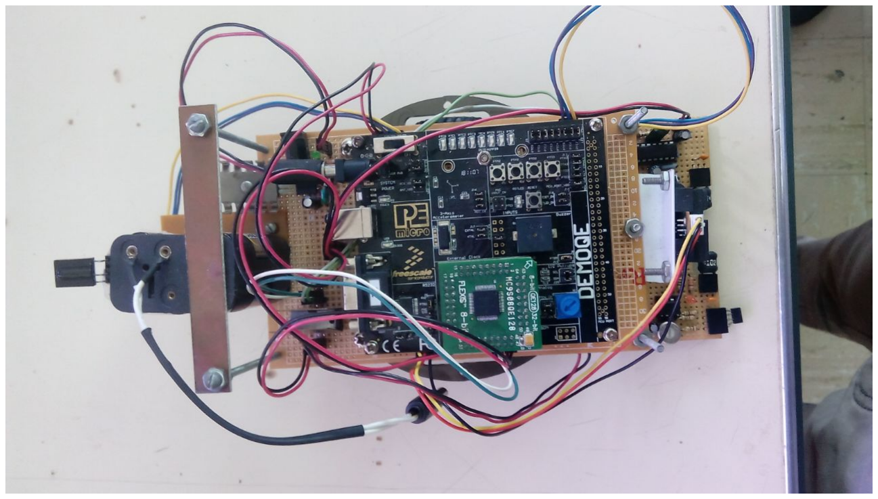
[picture p36: figure]

Figura 23: Baquelita del microcontrolador.

El enfoque del diseño en baquelita fue del tipo “Plug&Play” en el que fuera fácilmente accesible cada módulo por separado, lo que permitió hacer depuración tanto del hardware como del software de forma segura y cómoda.

## 4. Software

Esta sección presenta la arquitectura de software del sistema autónomo. Esta arquitectura es implementada con tres objetivos específicos:

Estimar posición del vehículo.

Planificar camino hasta la meta.

Comunicar el computador con el vehículo.

La funcionalidad de esta arquitectura implementada es detallada en la Section 4.

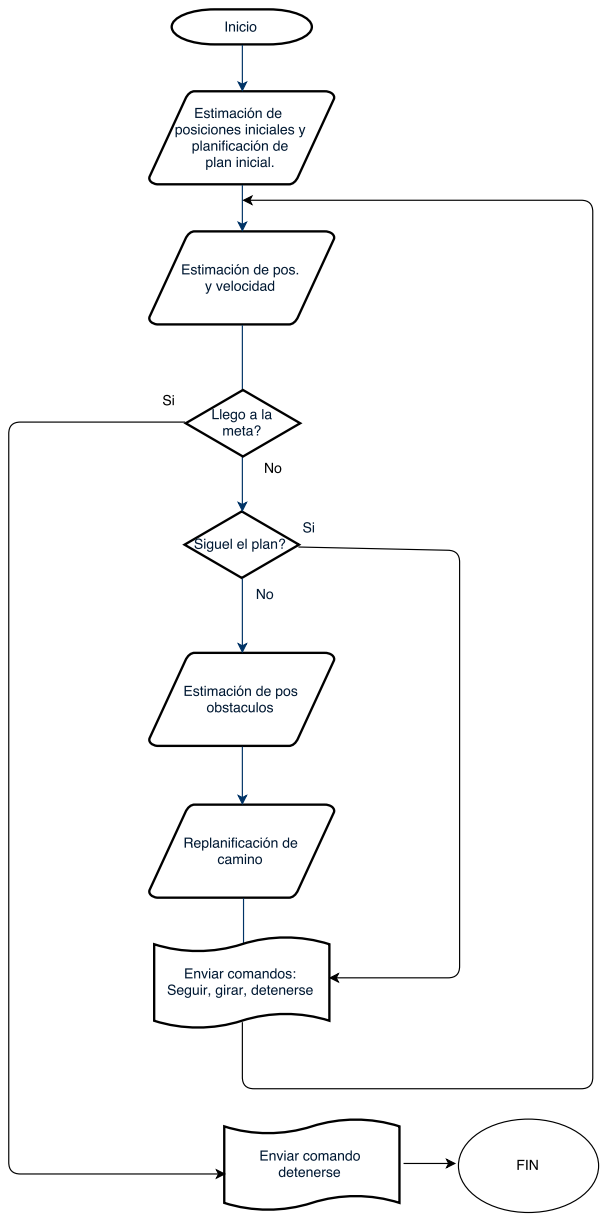
[picture p37: figure]

Figura 24: Arquitectura de Software

Una vez discretizado el espacio de trabajo del robot (en base a los cruces de la pista) se mapea cada inter-sección como nodo de un grafo, implementado en Python. Esta arquitectura de planificación es implementada en dos clases principales:

1. Robot: incluye las definiciones basicas del robot, su posición, su orientación y la ruta a seguir. Incluye métodos para estimar la posición y orientación del robot y definir la acción a tomar, en el archivorobot.py.

2. World: Establece el ambiente de trabajo como un grafo, en el archivo world.py.
3. Grafo: Define el elemento de nodo y las interconexiones e la pista, en el archivo graph.py.

A continuación, se presentan las especificaciones de la implementación de cada una de estas etapas.

### 4.1. Visión

La etapa de visión poro computadora se desarrolló en Python 3.5.0 bajo la librería OpenCV 3, dicha librería ofrece las siguientes funcionalidades de interés:

1. Interfaz con cámara de video.
2. Extracción de fondo de imagen.
3. Estimación de posición de objetos.

En particular, resultan de interés las funciones presentadas en la tabla Tabla 1

Tabla 1: Funciones de interés para la etapa de visión
inRange | Extrae los pixeles en un color de la imagen dada
erode | Elimina residuos de la extraccion de mascara del objeto
dilate | Dilata la mascara obtenida para reducción de ruido
findContours | calcula el contorno de las formas presentes en la máscara
minEnclosingCircle | Obtiene el radio y el centro del circulo presente en la máscara

Para estimar la posición del robot se comienza estimando mediante un sistema de visión por computadora, basado en OpenCV 3.0.0 para Python. El algoritmo principal realiza la estimación de la siguiente forma:

Hacer captura de cámara.

Obtener máscara de vehículo filtrando en el rango de colores del vehículo, aplicando erosión y dilatando la imagen.

Hallar circunferencia de mayor radio en la captura.

Tomar centro de circunferencia como ubicación del vehículo.

Ubicar el vehículo en un nodo del grafo.

Una vez estimado el nodo en que se ubica el vehículo se estima su orientación, debido a que solo se usa un punto como referencia de posición, no es posible estimar la orientación real del vehículo. Por lo tanto se estima la orientación mediante los cruces realizados entre cada par de grafos, asumiendo la orientación inicial del vehículo como constante.

### 4.2. Planificación

La planificación implementada se basó en teoria de grafos, sobre una versión discretizada del espacio de trabajo. Para ello se implementó una librería de grafos sobre Python 3.0 con los siguientes objetivos:

1. Representación de caminos unidireccionales y bidireccionales.
2. Representación de heurísticas admisibles basadas en distancia.
3. Inhabilitación de caminos.
4. Planificación de caminos basada en búsquedas discretas con heurística.

Esta última etapa resulta de mayor interés para este proyecto, pues debe ser capaz de calcular el cámino mas corto entre dos puntos dados. Para esto se utilizó el algoritmo de busqueda A*, pues resulta en planes óptimos con poca exigencia computacional, como se muestra en la Figura 25


Figura 25: Interpretación gráfica del algoritmo A*

Una vez conocida la posición del vehículo es necesario planificar la trayectoria a seguir, operación que debe ser realizada a una tasa de tiempo real, tal que sea posible re-planificar cuando sea necesario. Debido a este requerimiento de velocidad y a la representación discreta del ambiente de decide hacer uso de algoritmo de busqueda de grafos como método de planificación de camino.

El algoritmo A* es implementado en base a una heuristica de distancia cartesiana entre la ubicación del robot y la meta, y se integra como parte de la clase robot.py.

### 4.3. Comunicación

La comunicación con el microcontrolador se realizó mediante protocolo serial, para ello se usó la librería serial incluida en Python 3.0 con un protocolo de comunicación binario de instrucciones simples. Como se muestra en la Figura 26, se utilizaron 3 elementos principales para realizar las comunicaciones dentro del proyecto. Se puede separar en dos etapas:

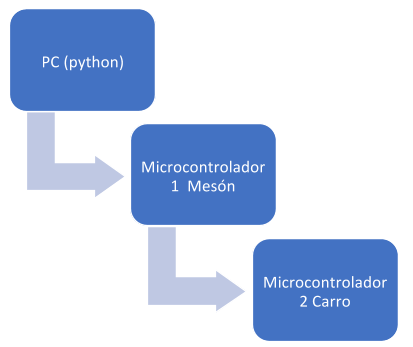
[picture p38: figure]

Figura 26: Diagrama de la comunicación

Comunicación PC-Microcontroldor1: Esta se refiere al intercambio de información entre el programa en Python (etapa anterior) sobre la acción que debe realizar el carro de acuerdo a la pista y los obstáculos presentes y el microcontrolador del mesón. Esta comunicación es unidireccional desde el Pc al microcontrolador. Sucede a través del protocolo de comunicación serial. Esta etapa es la encargada de encapsular un paquete de datos generados por el programa en Python que contiene la dirección que debe seguir el carro y el identificador (opcional) y se envía utilizando un carácter de la siguiente forma:

- “G” = acción adelante.
- “S” = acción detenerse.
- “I” = acción cruce izquierda.
- “D” = acción cruce derecha.
- “A” = acción retroceder.

Para evitar errores en el establecimiento de la comunicación, se decidió implementar un protocolo de 3 vías o conocido como “handshake”. Consiste en enviar desde el PC un carácter (en nuestro caso C), donde se indica que el dispositivo está listo para enviar. Del otro lado, el microcontrolador está esperando recibir un C. Una vez que es recibida, se entera que puede iniciarse la comunicación y envía otro carácter, en nuestro caso C. Y el computador, tras enviar dicho carácter, queda a la espera del carácter de confirmación, conocido como ACK. Una vez la PC recibe la última C desde el microcontrolador se inicia la comunicación regular.

Comunicación Microcontrolador1-Microcontrolador2: Este intercambio de datos se establece entre el microcontrolador del mesón y el microcontrolador ubicado en el carrito. La comunicación se establece a través de un protocolo propio utilizando la tecnología infrarroja (TSOP1136). Este dispositivo tiene características particulares de uso disponible en su hoja de datos, como recibir trenes de pulsos cuadrados de 36KHz, los cuales fueron aplicados al algoritmo de envío y recepción respectivamente. Para establecer la comunicación unidireccional con el sentido Microcontrolador 1 – Microcontrolador 2, se utilizan dos circuitos externos expuestos previamente. Los mensajes utilizados fueron enviados a través de 5 bits distribuidos de la siguiente forma:

- “100000” = adelante.
- “010000” = detenerse.
- “001000” = cruce izquierda.
- “000100” = cruce derecha.
- “000001” = retroceder.

Se utilizó esta codificación para poder detectar fácilmente los errores en la transmisión de los datos. El algoritmo implementado en el microcontrolador 2 es capaz de saber si efectivamente el mensaje recibido es un mensaje válido y en el caso contrario, descartarlo.

Por otro lado, se obtuvieron errores en cuanto a la sincronización del envío y recepción de datos a través de este medio, por lo que se decidió implementar un preámbulo a cada mensaje con el fin de brindar sincronización a la comunicación y obtener mensajes coherentes. El preámbulo utilizado fue “011”. El microcontrolador al detectar esta secuencia de bits en un mensaje, interpreta que está en pleno proceso de recepción de un mensaje valido y almacena los próximos 5 bits. Posteriormente valida el mensaje recibido y toma la acción correspondiente.

La Figura 27 presenta las lecturas en osciloscopio del mensaje enviado y recibido.

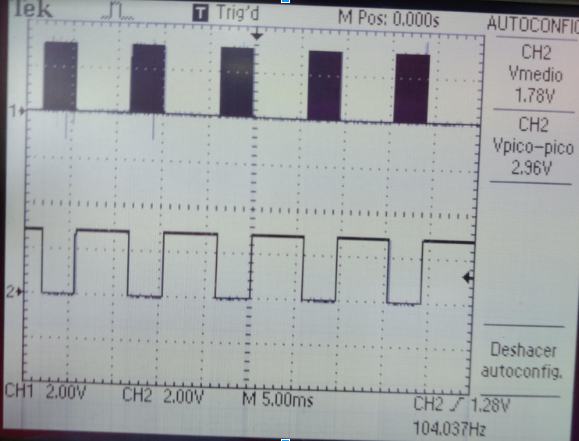
[picture p39: figure]

Figura 27: Señales de envío (parte superior) y recepción (parte inferior) infrarroja

Se aprecia en el canal 1, la salida del microcontrolador 1, donde se observan trenes de pulsos al enviar un 1, y bajos al enviar 0. Por otro lado, en el canal 2, se muestra la recepción de dichos pulsos en al-tos de 2.96 V en el caso de haber enviado un 0 lógico o un bajo de 0 V en caso de haber enviado un 1 lógico.

Toda comunicación tarda un tiempo en transmitir el mensaje, lo cual se traduce en un retraso entre la transmisión y la recepción. A continuación, en la Figura 28 se muestra la medición de dicho retraso que, para la aplicación utilizada, no representa un inconveniente. El retraso es de 102 microsegundos.

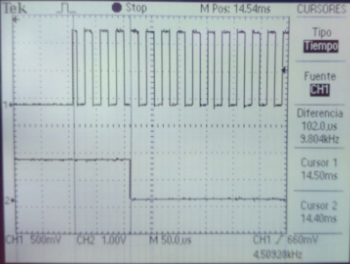
[picture p40: figure]

Figura 28: Retardo del mensaje recibido respecto al mensaje enviado

### 4.4. Firmware del Vehículo Autoguíado

Se utilizó el microcontrolador HCS08QE128 de NXP Semiconductors y el módulo de desarrollo DemoQE128 del mismo fabricante. Se programó utilizando el IDE CodeWarrior 10.6.

El firmware del vehículo debe integrar los distintos módulos ya detallados y generar una solución eficiente para proveer de tiempos de ejecución aceptables. Se utilizó una máquina de estados e interrupciones con tem-porizadores para iniciar su ejecución tras cada nuevo ciclo y manejar la comunicación con el sistema de visión por computadora.

Se implementaron 6 estados: ESTADO0, LEER BOBINAS, CONTROL PWM, LEER DISTANCIA, SE-NAL CRUCE y TRANSMISION SERIAL. El primero de ellos es necesario para no permitir que la ejecución continúe. Se fija, utilizando la interrupción respectiva, la velocidad de la máquina en 50 ciclos por segundo. EL segundo adquiere el valor de las bobinas utilizando los módulos de conversión ADC de los cuales dispone el µC. El tercero se encarga de establecer las variables de control y asignar los anchos de pulsos respectivos de la señal PWM que va hacia los motores, dependiendo del modo en el cual se encuentre el AGV. Se disponen de 5 primitivas o modos: ADELANTE, REVERSA, TURN RIGHT, TURN LEFT y DETENER. La Figura 29 describe el cambio entre cada una de estas.

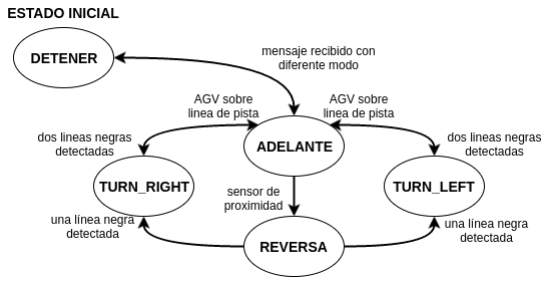
[picture p41: figure]

Figura 29: Modos de ejecución del AGV

El cuarto estado se encarga de adquirir el valor del sensor de proximidad por infrarojo. Nuevamente se utiliza el módulo ADC y se implementa esta vez un filtro Moving Average de 4 muestras para promediar los valores obtenidos. Dependiendo del valor registrado, en el rango 0 -255, se fija un valor de threshold (100) a partir del cual el objeto en frente del vehículo se encuentra a una distancia lo suficientemente cercana como para activar una acción en el AGV.

El quinto registra las líneas negras sobre cada cruce. Se genera una acción, si el AGV va hacia adelante, al detectar dos líneas consecutivas. Para el vehículo en modo reversa, se requiere solamente detectar la primera de ellas. Se implementa además otro filtro Moving Average para evitar falsos positivos durante el recorrido sobre la pista.

El último estado, con propósitos de control de ejecución, transmite el valor de los anchos de pulsos PWM respectivos a través del terminal serial del módulo de desarrollo. La Figura 30 describe el comportamiento del firmware a través de diagramas de flujo.

Finalmente, la Figura 31 describe el proceso de recepción de mensajes. Se establece un preámbulo válido, en el receptor, de 3 bits (100). A partir de la recepción de estos valores, se continua con los siguiente 5 bits que componen el mensaje respectivo. Se definen 5 tipos de mensajes, uno para cada primitiva del AGV.

Con propósitos de verificación, el apéndice A contiene los códigos de programación utilizados en el vehículo. Adicionalmente, en los siguientes enlaces se logran observar las distintas pruebas realizadas:

Recorrido libre:

- https://www.youtube.com/watch?v=pCBhxK1X9sM
- https://www.youtube.com/watch?v=Kj2bGL5unXg

Recorrido con obstáculos:

- https://www.youtube.com/watch?v=-YINWiGF6Xo
- https://www.youtube.com/watch?v=RY47U0YADUw

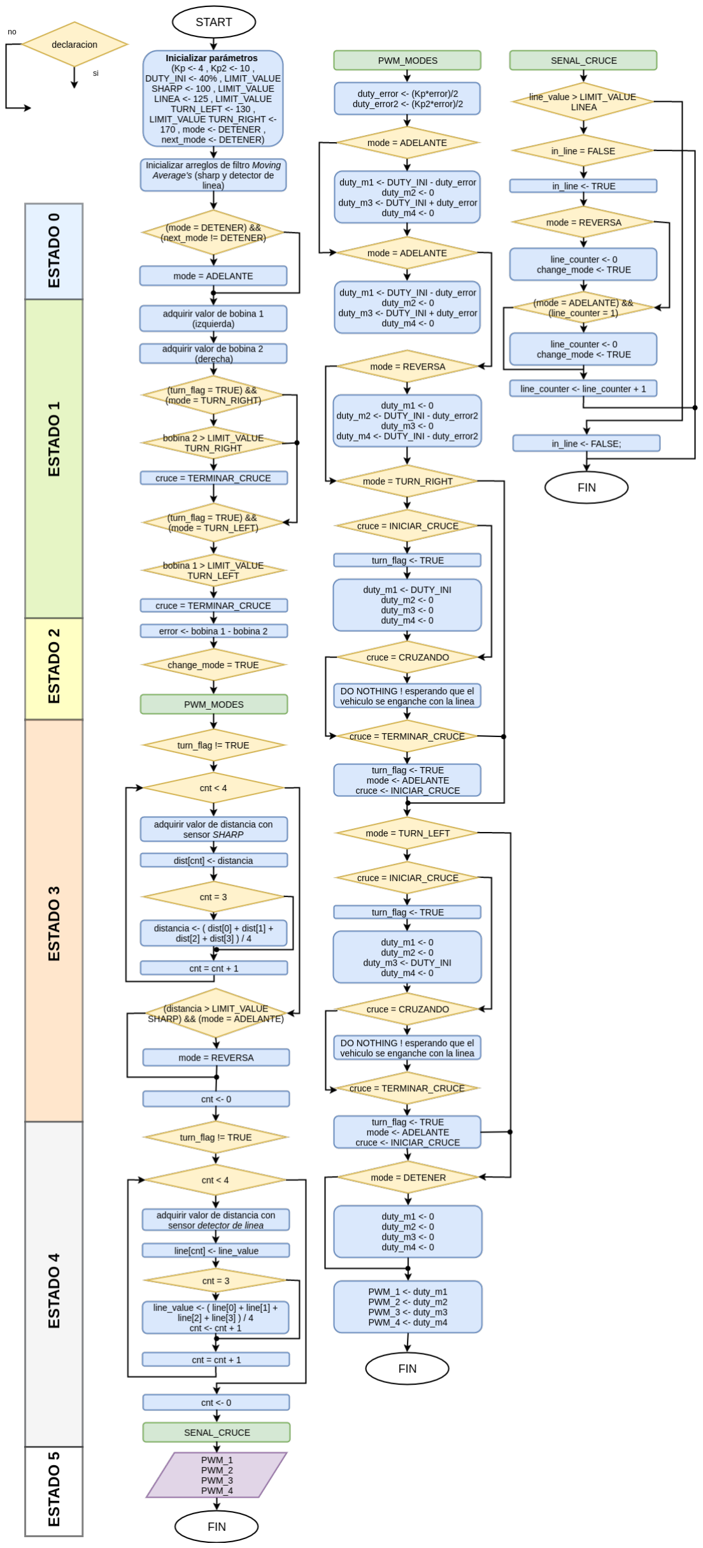
[picture p42: figure]

Figura 30: Diagrama de flujo que explica el Firmware del Vehículo Autoguiado

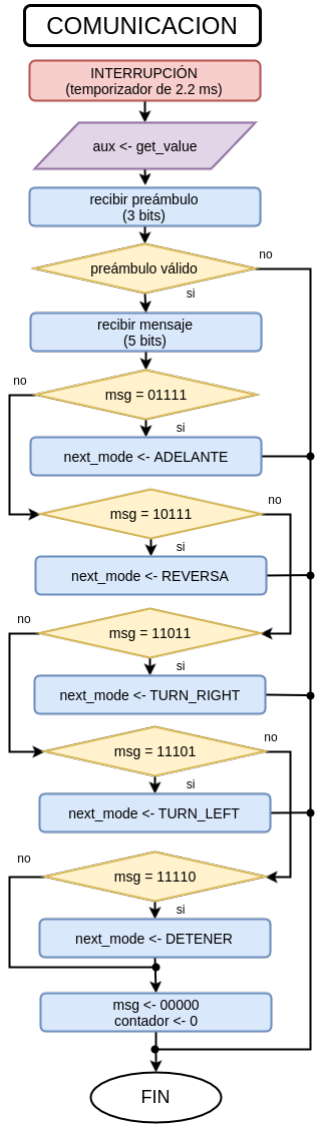
[picture p43: figure]

Figura 31: Diagrama de flujo que explica el Firmware del Vehículo Autoguiado

### 4.5. Consideraciones finales

El enfoque de diseño de software se basabas en programación de objetos, generando clases especificas para el robot, el espacio de trabajo y el sistema de comunicación, resultando en un funcionamiento satisfactorio en todos los escenarios de diseño requeridos. Sin embargo, se pueden plantear una serie de consideraciones para implementaciones futuras, especificamente en las siguientes etapas:

Visión por computador: en un futuro, podria ser de mayor utilidad detectar tanto la orientación como la posición del vehiculo. Tal avance requeriría la asignación de un color extra al robot o el uso de una forma conocida para la mascara de robot, de forma que se pueda estimar la orientación del vehiculo, permitiendo el inicio del movimiento desde posiciones y orientaciones arbitrarias.

Planificación de camino: La planificación de trayectorias se realizo de forma eficiente mediante al algoritmo A*. Sin embargo, es posible que en un futuro tambien se empleen métodos de planificación en espacios continuos, como lo son los campos de potencial y la optimización de trayectorias, lo que permitiría considerar restricciones adicionales en el problema de planificación, como los obstaculos y el movimiento no restringido a una linea.

Comunicación: El sistema de comunicación basado en infrarrojo resulto satisfactorio para el entorno de trabaja empleado. Sin embargo, este tipo de comunicación cuenta con la desventaja de ser muy susceptible a las interferencias externas, generando errores cuando multiples fuentes se encuentran presentes en el ambiente de trabajo. Por lo tanto en un futuro podría resultar de interés el hacer uso de protocolos alternos de comunciación, como Wi-Fi ó Bluetooth, pues son de mayor confianza a la hora de trasmitir paquetes de datos y garantizan mayor robustez ante interferencias en el ambiente.

## Apéndice A

Robot.py

1 | from c o l l e c t i o n s import deque
2 | import numpy a s np
3 | import cv2
4 | import s e r i a l

5
6 c l a s s r o b o t ( o b j e c t ) :

7
8 | d e f | i n i t | ( s e l f ) :
9 | s e l f . i d = 0xFF
10 | s e l f . pos = [ 0 , 0 ]
11 | s e l f . v el = [ 0 , 0 ]
12 | s e l f . node = ’ 1 ’
13 | s e l f . i d = ’L ’
14 | # e s t a d o s = ”STOP” , ”ATRAS” , ”DER” , ”IZQ” , ”GO”
15 | s e l f . cond = 0
16 | s e l f . s t a t e = ”STOP”
17 | s e l f . dt = 0. 1
18 | s e l f . l b = ( 1 0 , 1 0 0 , 1 0 0 )
19 | s e l f . ub = ( 3 0 , 2 5 5 , 2 5 5 )

20
21 | d e f g e t p o s ( s e l f , camera ) :
22 | # o b ti e n e l a imagen d el e s p a ci o de t r a b a j o
23 | ( grabbed , frame ) = camera . re ad ( )
24 | frame = cv2 . r e s i z e ( frame , ( 5 0 0 , 5 0 0 ) )
25 | ancho = 500
26 | l a r g o = 500
27 | #frame = i m u t i l s . r e s i z e ( frame , width =600)
28 | bl u r r e d = cv2 . G au s si anBlu r ( frame , ( 1 1 , 1 1 ) , 0 )
29 | hsv = cv2 . c v tC ol o r ( frame , cv2 .COLOR BGR2HSV)

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

35
36 | r e s = cv2 . bi t wi s e a n d ( frame , frame , mask = mask )

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

47
48 | # c a l c u l a l a v el o ci d a d d el v e hi c ul o
49 | dx = x − s e l f . pos [ 0 ]
50 | dy = y − s e l f . pos [ 1 ]
51 | s e l f . v el = [ dx/ s e l f . dt , dy/ s e l f . dt ]

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

55
56 | s e l f . node = 0

57
58 | | #NODO 1
59 | i f ( s e l f . pos [ 0 ] >= ( ( 0 ∗ ancho ) / 4 ) ) and ( s e l f . pos [ 0 ] <= ( ( 1 ∗ ancho ) / 4 ) ) and ( s e l f . pos [ 1 ]
>= ( ( 0 ∗ l a r g o ) / 3 ) ) and ( s e l f . pos [ 1 ] <= ( ( 1 ∗ l a r g o ) / 3 ) ) :
60 | s e l f . node = ”1”

61
62 | | #NODO 8
63 | i f ( s e l f . pos [ 0 ] >= ( ( 0 ∗ ancho ) / 4 ) ) and ( s e l f . pos [ 0 ] <= ( ( 1 ∗ ancho ) / 4 ) ) and ( s e l f . pos [ 1 ]
>= ( ( 1 ∗ l a r g o ) / 3 ) ) and ( s e l f . pos [ 1 ] <= ( ( 2 ∗ l a r g o ) / 3 ) ) :
64 | s e l f . node = ”8”

65
66 | | #NODO 9
67 | i f ( s e l f . pos [ 0 ] >= ( ( 0 ∗ ancho ) / 4 ) ) and ( s e l f . pos [ 0 ] <= ( ( 1 ∗ ancho ) / 4 ) ) and ( s e l f . pos [ 1 ]
>= ( ( 2 ∗ l a r g o ) / 3 ) ) and ( s e l f . pos [ 1 ] <= ( ( 3 ∗ l a r g o ) / 3 ) ) :

68 | s e l f . node = ”9”

69
70 | #NODO 2
71 | i f ( s e l f . pos [ 0 ] >= ( ( 1 ∗ ancho ) / 4 ) ) and ( s e l f . pos [ 0 ] <= ( ( 2 ∗ ancho ) / 4 ) ) and ( s e l f . pos [ 1 ]
| >= ( ( 0 ∗ l a r g o ) / 3 ) ) and ( s e l f . pos [ 1 ] <= ( ( 1 ∗ l a r g o ) / 3 ) ) :
72 | s e l f . node = ”2”

73
74 | #NODO 7
75 | i f ( s e l f . pos [ 0 ] >= ( ( 1 ∗ ancho ) / 4 ) ) and ( s e l f . pos [ 0 ] <= ( ( 2 ∗ ancho ) / 4 ) ) and ( s e l f . pos [ 1 ]
| >= ( ( 1 ∗ l a r g o ) / 3 ) ) and ( s e l f . pos [ 1 ] <= ( ( 2 ∗ l a r g o ) / 3 ) ) :
76 | s e l f . node = ”7”

77
78 | #NODO 10
79 | i f ( s e l f . pos [ 0 ] >= ( ( 1 ∗ ancho ) / 4 ) ) and ( s e l f . pos [ 0 ] <= ( ( 2 ∗ ancho ) / 4 ) ) and ( s e l f . pos [ 1 ]
| >= ( ( 2 ∗ l a r g o ) / 3 ) ) and ( s e l f . pos [ 1 ] <= ( ( 3 ∗ l a r g o ) / 3 ) ) :
80 | s e l f . node = ”10”

81
82 | #NODO 3
83 | i f ( s e l f . pos [ 0 ] >= ( ( 2 ∗ ancho ) / 4 ) ) and ( s e l f . pos [ 0 ] <= ( ( 3 ∗ ancho ) / 4 ) ) and ( s e l f . pos [ 1 ]
| >= ( ( 0 ∗ l a r g o ) / 3 ) ) and ( s e l f . pos [ 1 ] <= ( ( 1 ∗ l a r g o ) / 3 ) ) :
84 | s e l f . node = ”3”

85
86 | #NODO 6
87 | i f ( s e l f . pos [ 0 ] >= ( ( 2 ∗ ancho ) / 4 ) ) and ( s e l f . pos [ 0 ] <= ( ( 3 ∗ ancho ) / 4 ) ) and ( s e l f . pos [ 1 ]
| >= ( ( 1 ∗ l a r g o ) / 3 ) ) and ( s e l f . pos [ 1 ] <= ( ( 2 ∗ l a r g o ) / 3 ) ) :
88 | s e l f . node = ”6”

89
90 | #NODO 11
91 | i f ( s e l f . pos [ 0 ] >= ( ( 2 ∗ ancho ) / 4 ) ) and ( s e l f . pos [ 0 ] <= ( ( 3 ∗ ancho ) / 4 ) ) and ( s e l f . pos [ 1 ]
| >= ( ( 2 ∗ l a r g o ) / 3 ) ) and ( s e l f . pos [ 1 ] <= ( ( 3 ∗ l a r g o ) / 3 ) ) :
92 | s e l f . node = ”11”

93
94 | #NODO 4
95 | i f ( s e l f . pos [ 0 ] >= ( ( 3 ∗ ancho ) / 4 ) ) and ( s e l f . pos [ 0 ] <= ( ( 4 ∗ ancho ) / 4 ) ) and ( s e l f . pos [ 1 ]
| >= ( ( 0 ∗ l a r g o ) / 3 ) ) and ( s e l f . pos [ 1 ] <= ( ( 1 ∗ l a r g o ) / 3 ) ) :
96 | s e l f . node = ”4”

97
98 | #NODO 5
99 | i f ( s e l f . pos [ 0 ] >= ( ( 3 ∗ ancho ) / 4 ) ) and ( s e l f . pos [ 0 ] <= ( ( 4 ∗ ancho ) / 4 ) ) and ( s e l f . pos [ 1 ]
| >= ( ( 1 ∗ l a r g o ) / 3 ) ) and ( s e l f . pos [ 1 ] <= ( ( 2 ∗ l a r g o ) / 3 ) ) :
100 | s e l f . node = ”5”

101
102 | #NODO 12
103 | i f ( s e l f . pos [ 0 ] >= ( ( 3 ∗ ancho ) / 4 ) ) and ( s e l f . pos [ 0 ] <= ( ( 4 ∗ ancho ) / 4 ) ) and ( s e l f . pos [ 1 ]
| >= ( ( 2 ∗ l a r g o ) / 3 ) ) and ( s e l f . pos [ 1 ] <= ( ( 3 ∗ l a r g o ) / 3 ) ) :
104 | s e l f . node = ”12”

105
106 | #Show frame
107 | cv2 . r e c t a n g l e ( r e s , ( ( ( 0 ∗ ancho ) / 4 ) , ( ( 0 ∗ l a r g o ) / 3 ) ) , ( ( ( 1 ∗ ancho ) / 4 ) , ( ( 1 ∗ l a r g o ) / 3 ) )
| , ( 0 , 2 5 5 , 0 ) , 2 )
108 | cv2 . r e c t a n g l e ( r e s , ( ( ( 1 ∗ ancho ) / 4 ) , ( ( 0 ∗ l a r g o ) / 3 ) ) , ( ( ( 2 ∗ ancho ) / 4 ) , ( ( 1 ∗ l a r g o ) / 3 ) )
| , ( 0 , 2 5 5 , 0 ) , 2 )
109 | cv2 . r e c t a n g l e ( r e s , ( ( ( 2 ∗ ancho ) / 4 ) , ( ( 0 ∗ l a r g o ) / 3 ) ) , ( ( ( 3 ∗ ancho ) / 4 ) , ( ( 1 ∗ l a r g o ) / 3 ) )
| , ( 0 , 2 5 5 , 0 ) , 2 )
110 | cv2 . r e c t a n g l e ( r e s , ( ( ( 3 ∗ ancho ) / 4 ) , ( ( 0 ∗ l a r g o ) / 3 ) ) , ( ( ( 4 ∗ ancho ) / 4 ) , ( ( 1 ∗ l a r g o ) / 3 ) )
| , ( 0 , 2 5 5 , 0 ) , 2 )
111 | cv2 . r e c t a n g l e ( r e s , ( ( ( 0 ∗ ancho ) / 4 ) , ( ( 1 ∗ l a r g o ) / 3 ) ) , ( ( ( 1 ∗ ancho ) / 4 ) , ( ( 2 ∗ l a r g o ) / 3 ) )
| , ( 0 , 2 5 5 , 0 ) , 2 )
112 | cv2 . r e c t a n g l e ( r e s , ( ( ( 1 ∗ ancho ) / 4 ) , ( ( 1 ∗ l a r g o ) / 3 ) ) , ( ( ( 2 ∗ ancho ) / 4 ) , ( ( 2 ∗ l a r g o ) / 3 ) )
| , ( 0 , 2 5 5 , 0 ) , 2 )
113 | cv2 . r e c t a n g l e ( r e s , ( ( ( 2 ∗ ancho ) / 4 ) , ( ( 1 ∗ l a r g o ) / 3 ) ) , ( ( ( 3 ∗ ancho ) / 4 ) , ( ( 2 ∗ l a r g o ) / 3 ) )
| , ( 0 , 2 5 5 , 0 ) , 2 )
114 | cv2 . r e c t a n g l e ( r e s , ( ( ( 3 ∗ ancho ) / 4 ) , ( ( 1 ∗ l a r g o ) / 3 ) ) , ( ( ( 4 ∗ ancho ) / 4 ) , ( ( 2 ∗ l a r g o ) / 3 ) )
| , ( 0 , 2 5 5 , 0 ) , 2 )
115 | cv2 . r e c t a n g l e ( r e s , ( ( ( 0 ∗ ancho ) / 4 ) , ( ( 2 ∗ l a r g o ) / 3 ) ) , ( ( ( 1 ∗ ancho ) / 4 ) , ( ( 3 ∗ l a r g o ) / 3 ) )
| , ( 0 , 2 5 5 , 0 ) , 2 )
116 | cv2 . r e c t a n g l e ( r e s , ( ( ( 1 ∗ ancho ) / 4 ) , ( ( 2 ∗ l a r g o ) / 3 ) ) , ( ( ( 2 ∗ ancho ) / 4 ) , ( ( 3 ∗ l a r g o ) / 3 ) )
| , ( 0 , 2 5 5 , 0 ) , 2 )
117 | cv2 . r e c t a n g l e ( r e s , ( ( ( 2 ∗ ancho ) / 4 ) , ( ( 2 ∗ l a r g o ) / 3 ) ) , ( ( ( 3 ∗ ancho ) / 4 ) , ( ( 3 ∗ l a r g o ) / 3 ) )
| , ( 0 , 2 5 5 , 0 ) , 2 )
118 | cv2 . r e c t a n g l e ( r e s , ( ( ( 3 ∗ ancho ) / 4 ) , ( ( 2 ∗ l a r g o ) / 3 ) ) , ( ( ( 4 ∗ ancho ) / 4 ) , ( ( 3 ∗ l a r g o ) / 3 ) )
| , ( 0 , 2 5 5 , 0 ) , 2 )

119
120 | #Show frame
121 | cv2 . imshow ( ’ r e s ’ , r e s )

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

248
249 | m s g rec = p o r t . re ad ( )
250 | m s g rec 2 = p o r t . re ad ( )
251 | p r i n t ” c onec t ad o ”

252
253 | p r i n t m s g rec + m s g rec 2

World.py

1 | from r o b o t import r o b o t
2 | from SimpleGraph import SimpleGraph
3 | from P ri o ri t yQ u e u e import P ri o ri t yQ u e u e
4 | from Grid import Grid

5
6 | c l a s s world ( o b j e c t ) :
7 | d e f | i n i t | ( s e l f ) :
8 | # i n i c i a l i z a l a c l a s e de mundo
9 | s e l f . graph = SimpleGraph ( )
10 | s e l f . graph . ed ge s = { ’ 1 ’ : [ ’ 2 ’ , ’ 8 ’ ] ,
11 | | | ’ 2 ’ : [ ’ 1 ’ , ’ 3 ’ , ’ 7 ’ ] ,
12 | | | ’ 3 ’ : [ ’ 2 ’ , ’ 4 ’ , ’ 6 ’ ] ,
13 | | | ’ 4 ’ : [ ’ 3 ’ , ’ 5 ’ ] ,
14 | | | ’ 5 ’ : [ ’ 4 ’ , ’ 6 ’ , ’ 12 ’ ] ,
15 | | | ’ 6 ’ : [ ’ 3 ’ , ’ 5 ’ , ’ 7 ’ , ’ 11 ’ ] ,

16 | ’ 7 ’ : [ ’ 2 ’ , ’ 6 ’ , ’ 8 ’ , ’ 10 ’ ] ,
17 | ’ 8 ’ : [ ’ 1 ’ , ’ 7 ’ , ’ 9 ’ ] ,
18 | ’ 9 ’ : [ ’ 8 ’ , ’ 10 ’ ] ,
19 | ’ 10 ’ : [ ’ 7 ’ , ’ 9 ’ , ’ 11 ’ ] ,
20 | ’ 11 ’ : [ ’ 6 ’ , ’ 10 ’ , ’ 12 ’ ] ,
21 | ’ 12 ’ : [ ’ 5 ’ , ’ 11 ’ ] }
22 | s e l f . p o s i c i o n e s = { ’ 1 ’ : ( 1 , 1 ) ,
23 | ’ 2 ’ : ( 1 , 2 ) ,
24 | ’ 3 ’ : ( 1 , 3 ) ,
25 | ’ 4 ’ : ( 1 , 4 ) ,
26 | ’ 5 ’ : ( 2 , 1 ) ,
27 | ’ 6 ’ : ( 2 , 2 ) ,
28 | ’ 7 ’ : ( 2 , 3 ) ,
29 | ’ 8 ’ : ( 2 , 4 ) ,
30 | ’ 9 ’ : ( 3 , 1 ) ,
31 | ’ 10 ’ : ( 3 , 2 ) ,
32 | ’ 11 ’ : ( 3 , 3 ) ,
33 | ’ 12 ’ : ( 3 , 4 ) }
34 | s e l f . g o al = ’ 5 ’
35 | s e l f . s t a r t = ’ 1 ’
36 | s e l f . pl an = [ ]

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

41
42 | d e f c o s t ( s e l f , a , b ) :
43 | # d e f i n e una h e u r i s t i c a para l a busqueda in fo rmada
44 | ( x1 , y1 ) = a
45 | ( x2 , y2 ) = b
46 | r e t u r n abs ( x1 − x2 ) + abs ( y1 − y2 )

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

Graph.py

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

8 | d e f c o s t ( s e l f , a , b ) :
9 | r e t u r n 1

main.c

1 #i n cl u d e ”Cpu . h”
2 #i n cl u d e ” Events . h” 3 #i n cl u d e ”TI1 . h”
4 #i n cl u d e ”AD1. h”
5 #i n cl u d e ”AS1 . h”
6 #i n cl u d e ”PWM1. h”
7 #i n cl u d e ”PWM2. h”
8 #i n cl u d e ”PWM3. h”
9 #i n cl u d e ”PWM4. h”
10 #i n cl u d e ”TI2 . h” 11 #i n cl u d e ” Bi t 1 . h” 12 #i n cl u d e ” Bi t 2 . h”
13 #i n cl u d e ” Bi t 3 . h”

14
15 #i n cl u d e ”PE Types . h” 16 #i n cl u d e ”PE Error . h” 17 #i n cl u d e ”PE Const . h” 18 #i n cl u d e ”IO Map . h”

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

25
26 | // SOME DEFINITIONS
27 #d e f i n e DUTY INI M1 | | 400
28 #d e f i n e DUTY INI M2 | | 400
29 #d e f i n e LIMIT VALUE DIST | 100
30 #d e f i n e LIMIT VALUE LINE | 125
31 #d e f i n e LIMIT VALUE TURN RIGHT | 130
32 #d e f i n e LIMIT VALUE TURN LEFT | 170

33
34 un si gned ch a r e s t a d o = 0 ;

35
36 | // BOBINAS
37 | un si gned i n t bobina 1 , b o bin a 2 ;

38
39 | // CONTROL PWM
40 | si g n e d i n t e r r o r = 0 , DT = 0. 0 3 , i n t e g r a l e r r o r = 0 ; // <−− ∗∗ TIENEN QUE SER FLOAT ∗∗
41 | un si gned i n t duty m1 = 0 , duty m2 = 0 , duty m3 = 0 , duty m4 = 0 ;
42 | un si gned ch a r mode = DETENER;
43 | un si gned ch a r next mode = DETENER;
44 | un si gned ch a r c r u c e = INICIAR CRUCE ;

45
46 | // SENSOR DE DISTANCIA
47 | un si gned ch a r di s t a n c e = 0 , d i s t f i r [ 5 ] , cn t = 0 ;

48
49 | // COMUNICACION IR
50 | b o ol i r f l a g = FALSE; // TRUE == non−z e r o v al u e ; FALSE == 0

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

57
58 | // TRANSMISION SERIAL
59 | word snd = 0 ;
60 | un si gned ch a r j = 0 ;

61
62 | v oid main ( v oid ) {
63 | f o r ( cn t = 0 ; cn t < 4 ; cn t++){
64 | d i s t f i r [ cn t ] = 0 ;
65 | }
66 | cn t = 0 ;
67 | f o r ( cn t = 0 ; cn t < 4 ; cn t++){

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

76
77 | /∗
78 | ∗ | CICLO DE LA MAQUINA DE ESTADOS
79 | ∗ | ( 0 ) DO NOTHING
80 | ∗ | ( 1 ) LEE SENAL ELECTROMAGNETICA DE LAS BOBINAS
81 | ∗ | ( 2 ) CONTROL PWM DE LOS MOTORES
82 | ∗ | ( 3 ) LEE DISTANCIA DEL SENSOR SHARP
83 | ∗ | ( 4 ) EN CASO DE DETECTAR SENAL DE CRUCE
84 | ∗ | ( 5 ) TRANSMISION SERIAL PARA DEBUGGING
85 | ∗/

86
87 | swi t c h ( e s t a d o ) {
88 | c a s e ESTADO0:
89 | i f ( ( mode == DETENER) && ( next mode != DETENER) ) {
90 | mode = ADELANTE;
91 | }
92 | // H ell o World !
93 | break ;
94 | c a s e LEER BOBINAS:
95 | ( v oid ) AD1 MeasureChan (TRUE, 0 x00 ) ; // REALIZA MEDICION CANAL 0
96 | ( v oid ) AD1 GetChanValue16 ( 0 x00 ,& b obin a 1 ) ; // OBTIENE VALOR BOBINA 1
97 | b obin a 1 = b obin a 1 >> 8 ; // BIT SHIFTING
98 | ( v oid ) AD1 MeasureChan (TRUE, 0 x01 ) ; // REALIZA MEDICION CANAL 1
99 | ( v oid ) AD1 GetChanValue8 ( 0 x01 ,& b o bi n a 2 ) ; // OBTIENE VALOR BOBINA 2
100 | b obin a 2 = b obin a 2 >> 8 ; | // BIT SHIFTING
101 | i f ( t u r n f l a g ) {
102 | i f (mode == TURN RIGHT) {
103 | i f ( b o bi n a 2 > LIMIT VALUE TURN RIGHT) {
104 | c r u c e = TERMINAR CRUCE;
105 | }
106 | }
107 | e l s e i f (mode == TURN LEFT) {
108 | i f ( b o bi n a 1 > LIMIT VALUE TURN LEFT) {
109 | c r u c e = TERMINAR CRUCE;
110 | }
111 | }
112 | }
113 | e s t a d o = CONTROLPWM; // CHANGE STATE
114 | break ;
115 | c a s e CONTROLPWM:
116 | e r r o r = b obi n a 1 − b o bi n a 2 ; // RESTA DE SENAL EN BOBINAS

117
118 PWMMODES: | i f ( change mode ) {
119 | mode = next mode ;
120 | next mode = DETENER;
121 | change mode = FALSE;
122 | }
123 | i f (mode == ADELANTE) {
124 | duty m1 = DUTY INI M1 − (KP∗ e r r o r + KI∗ i n t e g r a l e r r o r ) / 2;
125 | duty m2 = 0 ;
126 | duty m3 = DUTY INI M2 + (KP∗ e r r o r + KI∗ i n t e g r a l e r r o r ) / 2;
127 | duty m4 = 0 ;
128 | }

129
130 | i f (mode == REVERSA) {
131 | duty m1 = 0 ;
132 | duty m2 = DUTY INI M1 + (KP∗ e r r o r + KI∗ i n t e g r a l e r r o r ) / 2;
133 | duty m3 = 0 ;
134 | duty m4 = DUTY INI M2 − (KP∗ e r r o r + KI∗ i n t e g r a l e r r o r ) / 2;
135 | }

136
137 | i f (mode == TURN RIGHT) {
138 | swi t c h ( c r u c e ) {
139 | c a s e INICIAR CRUCE :
140 | t u r n f l a g = TRUE;
141 | duty m1 = DUTY INI M1 ;
142 | duty m2 = 0 ;
143 | duty m3 = 0 ;

144 | duty m4 = 0 ;
145 | c r u c e = CRUZANDO;
146 | break ;
147 | c a s e CRUZANDO:
148 | // do n o thin g
149 | break ;
150 | c a s e TERMINAR CRUCE:
151 | t u r n f l a g = FALSE;
152 | mode = ADELANTE;
153 | c r u c e = INICIAR CRUCE ;
154 | g o t o PWMMODES;
155 | break ;
156 | }
157 | }

158
159 | i f (mode == TURN LEFT) {
160 | swi t c h ( c r u c e ) {
161 | c a s e INICIAR CRUCE :
162 | t u r n f l a g = TRUE;
163 | duty m1 = 0 ;
164 | duty m2 = 0 ;
165 | duty m3 = DUTY INI M2 ;
166 | duty m4 = 0 ;
167 | c r u c e = CRUZANDO;
168 | break ;
169 | c a s e CRUZANDO:
170 | // do n o thin g
171 | break ;
172 | c a s e TERMINAR CRUCE:
173 | t u r n f l a g = FALSE;
174 | mode = ADELANTE;
175 | c r u c e = INICIAR CRUCE ;
176 | g o t o PWMMODES;
177 | break ;
178 | }
179 | }

180
181 | i f (mode == DETENER) {
182 | duty m1 = 0 ;
183 | duty m2 = 0 ;
184 | duty m3 = 0 ;
185 | duty m4 = 0 ;
186 | }

187
188 | ( v oid )PWM1 SetDutyUS ( duty m1 ) ;
189 | ( v oid )PWM2 SetDutyUS ( duty m2 ) ;
190 | ( v oid )PWM3 SetDutyUS ( duty m3 ) ;
191 | ( v oid )PWM4 SetDutyUS ( duty m4 ) ;
192 | e s t a d o = LEER DISTANCIA; // CHANGE STATE
193 | break ;
194 | c a s e LEER DISTANCIA:
195 | i f ( ! t u r n f l a g ) {
196 | w hil e ( cn t < 4 ) { // MOVING AVERAGE FILTER
197 | ( v oid ) AD1 MeasureChan (TRUE, 0 x02 ) ;
198 | ( v oid ) AD1 GetChanValue8 ( 0 x02 ,& di s t a n c e ) ; // DISTANCE ADQUISITION
199 | d i s t f i r [ cn t ] = di s t a n c e ;
200 | i f ( cn t == 3 ) { // AVERAGE VALUE OF 4 MEASURES
201 | di s t a n c e = ( d i s t f i r [ 0]+ d i s t f i r [ 1]+ d i s t f i r [ 2]+ d i s t f i r [ 3 ] ) / 4;
202 | }
203 | cn t++; // SE AUMENTA EL CONTADOR
204 | }
205 | i f ( ( di s t a n c e > LIMIT VALUE DIST ) && (mode == ADELANTE) ) {
206 | mode = REVERSA; // OBJECT DETECTED ! STOP VEHICLE AND WAIT
207 | }
208 | cn t = 0 ; // SE REINICIA EL CONTADOR
209 | }
210 | e s t a d o = SENAL CRUCE; // CHANGE STATE
211 | break ;
212 | c a s e SENAL CRUCE:
213 | i f ( ! t u r n f l a g ) {
214 | w hil e ( cn t < 4 ) { // MOVING AVERAGE FILTER
215 | ( v oid ) AD1 MeasureChan (TRUE, 0 x03 ) ;
216 | ( v oid ) AD1 GetChanValue8 ( 0 x03 , &l i n e v a l u e ) ; // DISTANCE ADQUISITION
217 | l i n e v a l u e f i r [ cn t ] = l i n e v a l u e ;
218 | i f ( cn t == 3 ) { // AVERAGE VALUE OF 4 MEASURES
219 | l i n e v a l u e = ( l i n e v a l u e f i r [ 0]+ l i n e v a l u e f i r [ 1]+ l i n e v a l u e f i r [ 2]+

l i n e v a l u e f i r [ 3 ] ) / 4;

220 | }
221 | cn t++; // SE AUMENTA EL CONTADOR
222 | }
223 | cn t = 0 ; // SE REINICIA EL CONTADOR
224 | i f ( l i n e v a l u e > LIMIT VALUE LINE ) {
225 | i f ( ! i n l i n e ) {
226 | i n l i n e = TRUE;
227 | i f (mode == REVERSA) {
228 | l i n e c o u n t e r = 0 ;
229 | change mode = TRUE;
230 | // g o t o PWMMODES;
231 | }
232 | e l s e i f ( ( mode == ADELANTE) && ( l i n e c o u n t e r == 1 ) ) {
233 | l i n e c o u n t e r = 0 ;
234 | change mode = TRUE;
235 | // g o t o PWMMODES;
236 | }
237 | e l s e {
238 | l i n e c o u n t e r ++;
239 | }
240 | }
241 | } e l s e {
242 | i n l i n e = FALSE;
243 | }
244 | }
245 | e s t a d o = TRANSMISION SERIAL; // CHANGE STATE
246 | break ;
247 | c a s e TRANSMISION SERIAL:
248 | snd = 0 ; // VARIABLE AUXILIAR
249 | /∗ ( v oid ) AS1 SendBlock(&bobina 1 ,2 ,& snd ) ; // VALOR BOBINA #1
250 | snd = 0 ;
251 | ( v oid ) AS1 SendBlock(&bobina 2 ,2 ,& snd ) ; // VALOR BOBINA #2
252 | snd = 0 ;
253 | ( v oid ) AS1 SendBlock(& e r r o r ,2 ,& snd ) ; // VALOR DUTY CYCLE ( us )
254 | snd = 0 ; ∗/
255 | ( v oid ) AS1 SendBlock(&duty m1 , 2 , &snd ) ; // VALOR DUTY CYCLE ( us )
256 | snd = 0 ;
257 | ( v oid ) AS1 SendBlock(&duty m2 , 2 , &snd ) ; // VALOR DUTY CYCLE ( us )
258 | snd = 0 ;
259 | ( v oid ) AS1 SendBlock(&duty m3 , 2 , &snd ) ; // VALOR DUTY CYCLE ( us )
260 | snd = 0 ;
261 | ( v oid ) AS1 SendBlock(&duty m4 , 2 , &snd ) ; // VALOR DUTY CYCLE ( us )
262 | e s t a d o = ESTADO0; // CHANGE STATE
263 | break ;
264 | d e f a u l t :
265 | break ;
266 | }
267 | }
268 | #i f d e f PEX RTOS START
269 | PEX RTOS START( ) ; | /∗ S t a r tup o f the s e l e c t e d RTOS. Macro i s d e fi n e d by
| the RTOS component . ∗/
270 | #e n d i f
271 | }

events.c

1 #i n cl u d e ”Cpu . h”
2 #i n cl u d e ” Events . h”

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

10
11 | /∗
12 | ∗∗ ===================================================================
13 | ∗∗ | Event | : | T I 1 On In te r rup t ( module Events )
14 | ∗∗
15 | ∗∗ | Component | : | TI1 [ Timer Int ]
16 | ∗∗ | D e s c ri p ti o n :

17 | ∗∗ | When a tim e r i n t e r r u p t o c c u r s t h i s e ven t i s c a l l e d ( onl y
18 | ∗∗ | when the component i s en abled − <Enable> and the e v e n t s a r e
19 | ∗∗ | en abled − <EnableEvent >) . This e ven t i s en abled onl y i f a
20 | ∗∗ | <i n t e r r u p t s e r v i c e / event> i s en abled .
21 | ∗∗ | Parameters | : None
22 | ∗∗ | Returns | : Nothing
23 | ∗∗ ===================================================================
24 | ∗/
25 | v oid T I 1 On In te r rup t ( v oid ) {
26 | i f ( e s t a d o == ESTADO0) {
27 | e s t a d o = e s t a d o++;
28 | }
29 | }

30
31 | /∗
32 | ∗∗ ===================================================================
33 | ∗∗ | Event | : | T I 2 On In te r rup t ( module Events )
34 | ∗∗
35 | ∗∗ | Component | : | TI2 [ Timer Int ]
36 | ∗∗ | D e s c ri p ti o n :
37 | ∗∗ | When a tim e r i n t e r r u p t o c c u r s t h i s e ven t i s c a l l e d ( onl y
38 | ∗∗ | when the component i s en abled − <Enable> and the e v e n t s a r e
39 | ∗∗ | en abled − <EnableEvent >) . This e ven t i s en abled onl y i f a
40 | ∗∗ | <i n t e r r u p t s e r v i c e / event> i s en abled .
41 | ∗∗ | Parameters | : None
42 | ∗∗ | Returns | : Nothing
43 | ∗∗ ===================================================================
44 | ∗/
45 | v oid T I 2 On In te r rup t ( v oid ) {
46 | aux1 = Bi t 1 Ge tV al ( ) ;
47 | aux = aux1 ;
48 | aux1=0;
49 | //
50 | i f ( ( c on t ad o r == 0 ) && ( aux ) ) {
51 | | c on t ad o r = 1 ;
52 | } e l s e {
53 | i f ( ( c on t ad o r == 1 ) && ( ! aux ) ) {
54 | | c on t ad o r = 2 ;
55 | | } e l s e {
56 | i f ( ( c on t ad o r == 2 ) && ( ! aux ) ) {
57 | c on t ad o r = 3 ;
58 | | } e l s e {
59 | i f ( c on t ad o r < 3 ) {
60 | c on t ad o r = 0 ;
61 | | } e l s e {
62 | i f ( ( c on t ad o r > 2 ) && ( c on t ad o r < 8 ) ) {
63 | msg [ c on t ad o r − 3 ] = aux ;
64 | c on t ad o r++;
65 | | }
66 | | }
67 | }
68 | }
69 | }

70
71 | i f ( c on t ad o r == 8 ) {
72 | | Bit3 NegVal ( ) ;
73 | i f ( ( ! msg [ 0 ] ) && (msg [ 1 ] ) && (msg [ 2 ] ) && (msg [ 3 ] ) && (msg [ 4 ] ) ) {
74 | next mode = ADELANTE;
75 | Bit2 NegVal ( ) ;
76 | }
77 | i f ( ( msg [ 0 ] ) && ( ! msg [ 1 ] ) && (msg [ 2 ] ) && (msg [ 3 ] ) && (msg [ 4 ] ) ) {
78 | next mode = DETENER;
79 | Bit2 NegVal ( ) ;
80 | }
81 | i f ( ( msg [ 0 ] ) && (msg [ 1 ] ) && ( ! msg [ 2 ] ) && (msg [ 3 ] ) && (msg [ 4 ] ) ) {
82 | next mode = TURN LEFT;
83 | Bit2 NegVal ( ) ;
84 | }
85 | i f ( ( msg [ 0 ] ) && (msg [ 1 ] ) && (msg [ 2 ] ) && ( ! msg [ 3 ] ) && (msg [ 4 ] ) ) {
86 | next mode = TURN RIGHT;
87 | Bit2 NegVal ( ) ;
88 | }
89 | i f ( ( msg [ 0 ] ) && (msg [ 1 ] ) && (msg [ 2 ] ) && (msg [ 3 ] ) && ( ! msg [ 4 ] ) ) {
90 | next mode = REVERSA;
91 | Bit2 NegVal ( ) ;
92 | }

94 | msg [ 0 ] = FALSE;
95 | msg [ 1 ] = FALSE;
96 | msg [ 2 ] = FALSE;
97 | msg [ 3 ] = FALSE;
98 | msg [ 4 ] = FALSE;
99 | c on t ad o r = 0 ;
100 | }
101 | }

events.h

1 #i f n d e f | E ven t s H
2 #d e f i n e | E ven t s H
3 | /∗ MODULE Events ∗/

4
5 #i n cl u d e ”PE Types . h” 6 #i n cl u d e ”PE Error . h” 7 #i n cl u d e ”PE Const . h” 8 #i n cl u d e ”IO Map . h” 9 #i n cl u d e ”PE Timer . h” 10 #i n cl u d e ”TI1 . h”
11 #i n cl u d e ”AD1. h”
12 #i n cl u d e ”AS1 . h”
13 #i n cl u d e ”PWM1. h” 14 #i n cl u d e ”PWM2. h” 15 #i n cl u d e ”PWM3. h” 16 #i n cl u d e ”PWM4. h” 17 #i n cl u d e ”TI2 . h” 18 #i n cl u d e ” Bi t 1 . h” 19 #i n cl u d e ” Bi t 2 . h” 20 #i n cl u d e ” Bi t 3 . h”

21
22 // ESTADOS
23 #d e f i n e ESTADO0 0
24 #d e f i n e LEER BOBINAS 1 25 #d e f i n e CONTROLPWM 2
26 #d e f i n e LEER DISTANCIA 3
27 #d e f i n e SENAL CRUCE 4
28 #d e f i n e TRANSMISION SERIAL 5

29
30 | // MODOS DEL VEHICULO
31 #d e f i n e ADELANTE | 1
32 #d e f i n e REVERSA | 2
33 #d e f i n e TURN RIGHT | 3
34 #d e f i n e TURN LEFT 4 35 #d e f i n e DETENER 5

36
37 // ETAPAS DEL CRUCE
38 #d e f i n e INICIAR CRUCE 1
39 #d e f i n e CRUZANDO | 2
40 #d e f i n e TERMINAR CRUCE | 3

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

43
44 | v oid T I 1 On In te r rup t ( v oid ) ;
45 | /∗
46 | ∗∗ ===================================================================
47 | ∗∗ | Event | : | T I 1 On In te r rup t ( module Events )
48 | ∗∗
49 | ∗∗ | Component | : | TI1 [ Timer Int ]
50 | ∗∗ | D e s c ri p ti o n :
51 | ∗∗ | When a tim e r i n t e r r u p t o c c u r s t h i s e ven t i s c a l l e d ( onl y
52 | ∗∗ | when the component i s en abled − <Enable> and the e v e n t s a r e
53 | ∗∗ | en abled − <EnableEvent >) . This e ven t i s en abled onl y i f a
54 | ∗∗ | <i n t e r r u p t s e r v i c e / event> i s en abled .
55 | ∗∗ | Parameters | : None
56 | ∗∗ | Returns | : Nothing
57 | ∗∗ ===================================================================
58 | ∗/

59
60 | v oid T I 2 On In te r rup t ( v oid ) ;
61 | /∗

62 | ∗∗ ===================================================================
63 | ∗∗ | Event | : | T I 2 On In te r rup t ( module Events )
64 | ∗∗
65 | ∗∗ | Component | : | TI2 [ Timer Int ]
66 | ∗∗ | D e s c ri p ti o n :
67 | ∗∗ | When a tim e r i n t e r r u p t o c c u r s t h i s e ven t i s c a l l e d ( onl y
68 | ∗∗ | when the component i s en abled − <Enable> and the e v e n t s a r e
69 | ∗∗ | en abled − <EnableEvent >) . This e ven t i s en abled onl y i f a
70 | ∗∗ | <i n t e r r u p t s e r v i c e / event> i s en abled .
71 | ∗∗ | Parameters | : None
72 | ∗∗ | Returns | : Nothing
73 | ∗∗ ===================================================================
74 | ∗/

75
76 | /∗ END Events ∗/
77 #e n d i f /∗ | E ven t s H ∗/
