LPerezBustos/EC3883_AutomaticGuidedVehicle/circuits/GP2Y0A21YK_distance/GP2Y0A21YK_block_diagram.jpg

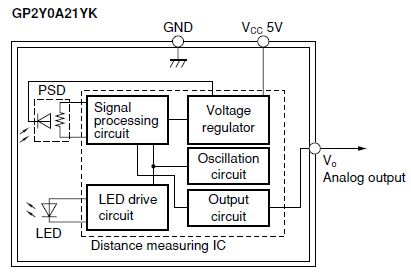
circuits/GP2Y0A21YK_distance/GP2Y0A21YK_block_diagram.jpg
