LPerezBustos/EC3883_AutomaticGuidedVehicle/circuits/IMG_20170116_161950.jpg

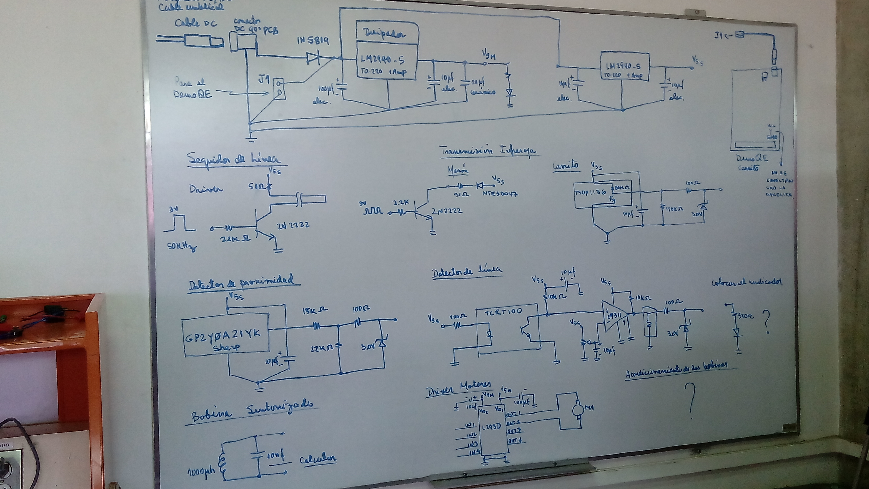
circuits/IMG_20170116_161950.jpg
