LPerezBustos/EC3883_AutomaticGuidedVehicle/circuits/IMG_20170116_162000.jpg

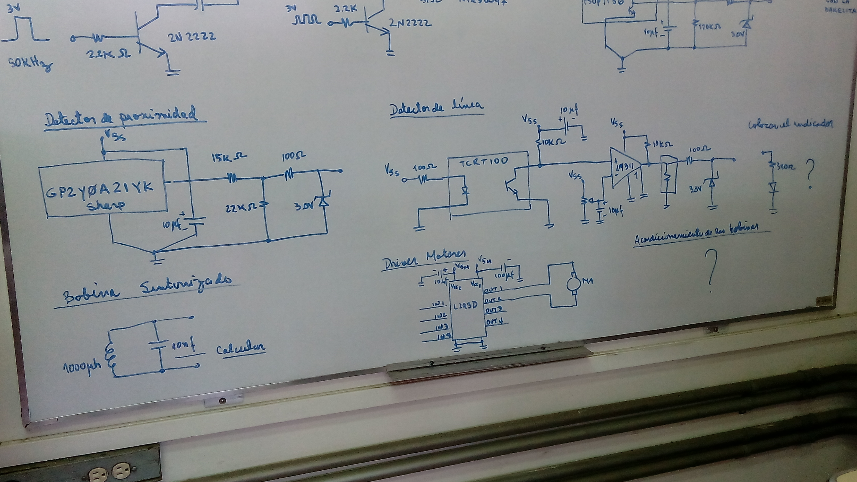
circuits/IMG_20170116_162000.jpg
