LPerezBustos/EC3883_AutomaticGuidedVehicle/circuits/TCRT1000_LineDetector/TCRT1000.JPG

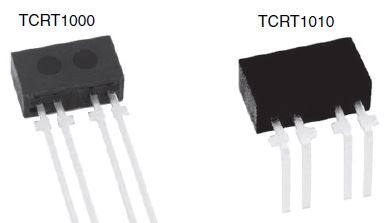
circuits/TCRT1000_LineDetector/TCRT1000.JPG
