LPerezBustos/EC3883_AutomaticGuidedVehicle/demoQE128.png

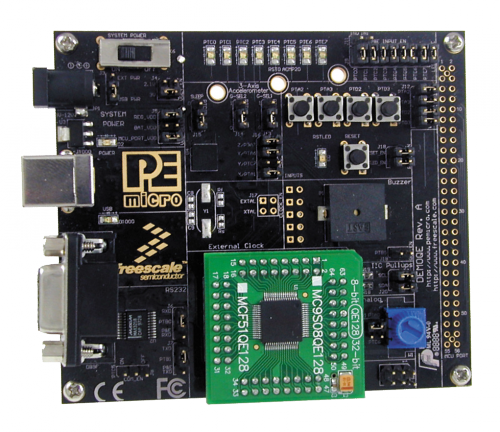
demoQE128.png
