LPerezBustos/EC3883_AutomaticGuidedVehicle/documentation/demoQE_pins.png

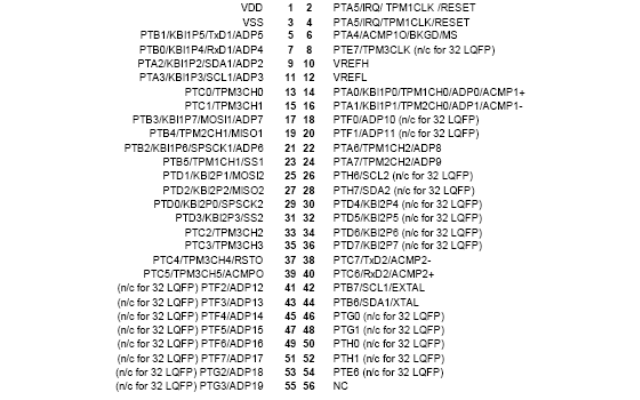
documentation/demoQE_pins.png
