LPerezBustos/EC3883_AutomaticGuidedVehicle/final-report/images/5_back.jpg

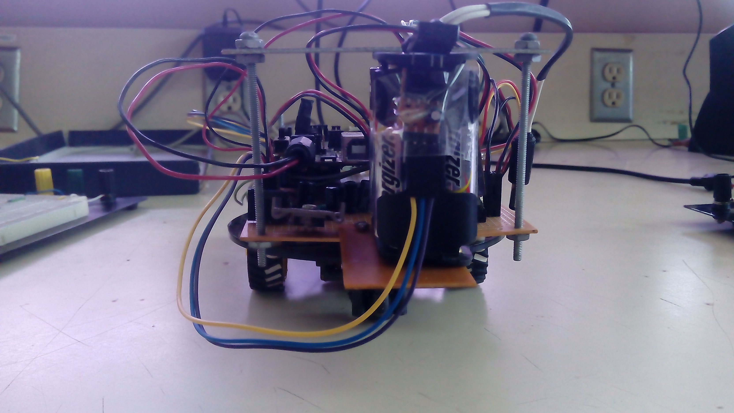
final-report/images/5_back.jpg
