LPerezBustos/EC3883_AutomaticGuidedVehicle/final-report/images/pwm&line_sensor.jpg

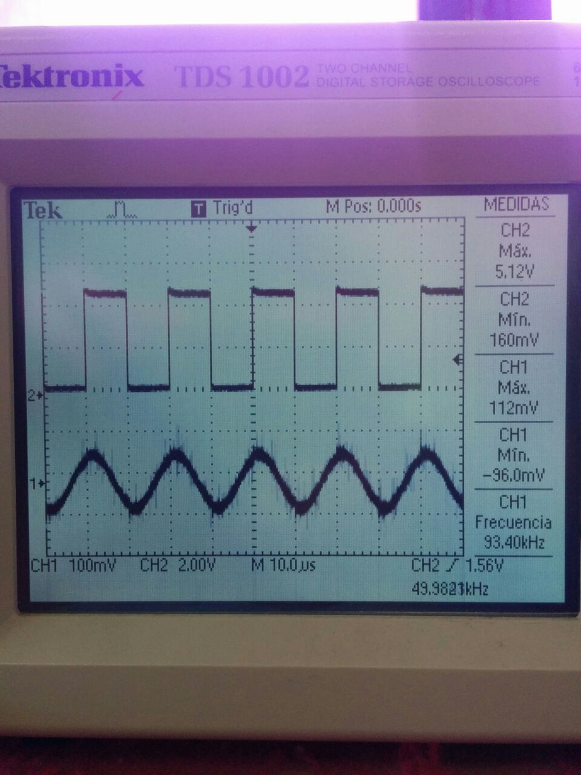
final-report/images/pwm&line_sensor.jpg
