LPerezBustos/EC3883_AutomaticGuidedVehicle/(list of files, cad)

Other CAD files:
project/embedded-firmware/FLASH/Sources/main_c.obj
project/embedded-firmware/FLASH/Generated_Code/TI1_c.obj
project/embedded-firmware/FLASH/Project_Settings/Startup_Code/start08_c.obj
project/embedded-firmware/FLASH/Generated_Code/PE_Timer_c.obj
project/embedded-firmware/FLASH/Sources/Events_c.obj
project/embedded-firmware/FLASH/Generated_Code/EInt1_c.obj
project/embedded-firmware/FLASH/Generated_Code/PWM3_c.obj
project/embedded-firmware/FLASH/Generated_Code/Cpu_c.obj
project/embedded-firmware/FLASH/Generated_Code/AS1_c.obj
project/embedded-firmware/FLASH/Generated_Code/Vectors_c.obj
project/embedded-firmware/FLASH/Generated_Code/IO_Map_c.obj
project/embedded-firmware/FLASH/Generated_Code/AD1_c.obj
project/embedded-firmware/FLASH/Generated_Code/PWM4_c.obj
project/embedded-firmware/FLASH/Generated_Code/PWM1_c.obj
project/embedded-firmware/FLASH/Generated_Code/PWM2_c.obj
