LPerezBustos/EC3883_AutomaticGuidedVehicle/final-report/images/1_soldering-process(1).jpg

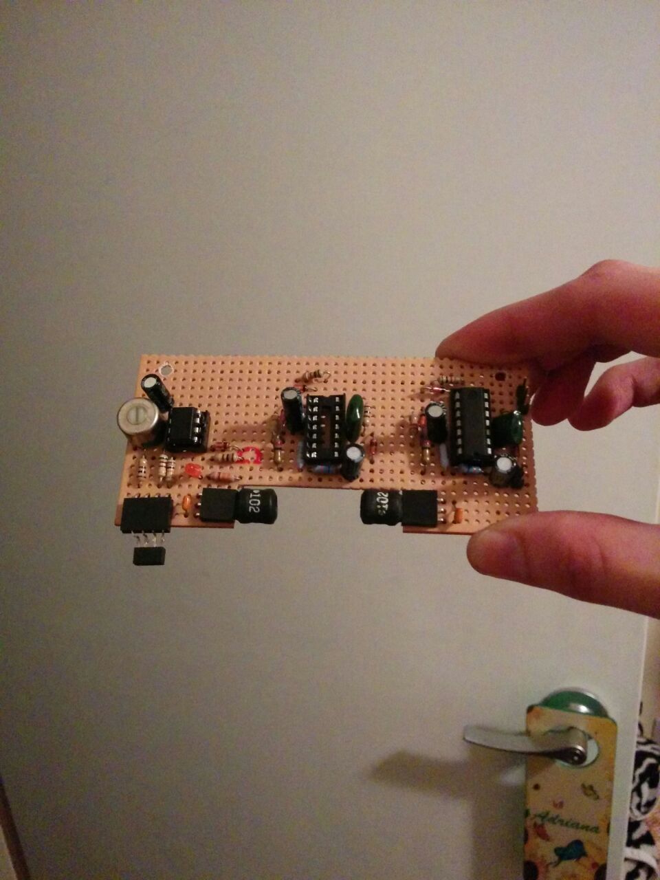
final-report/images/1_soldering-process(1).jpg
