LPerezBustos/EC3883_AutomaticGuidedVehicle/final-report/images/2_soldering-process(2).jpg

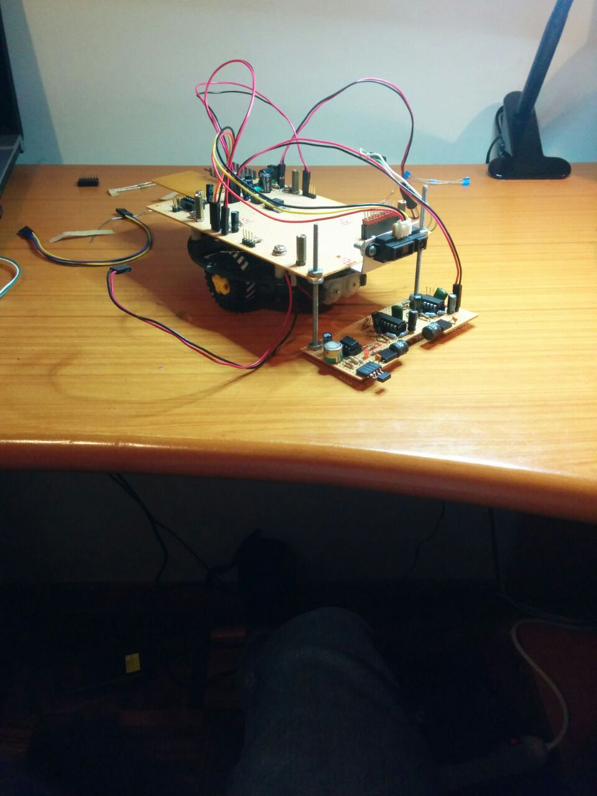
final-report/images/2_soldering-process(2).jpg
