LPerezBustos/EC3883_AutomaticGuidedVehicle/circuits/GP2Y0A21YK_distance/GP2Y0A21YK_2.pdf

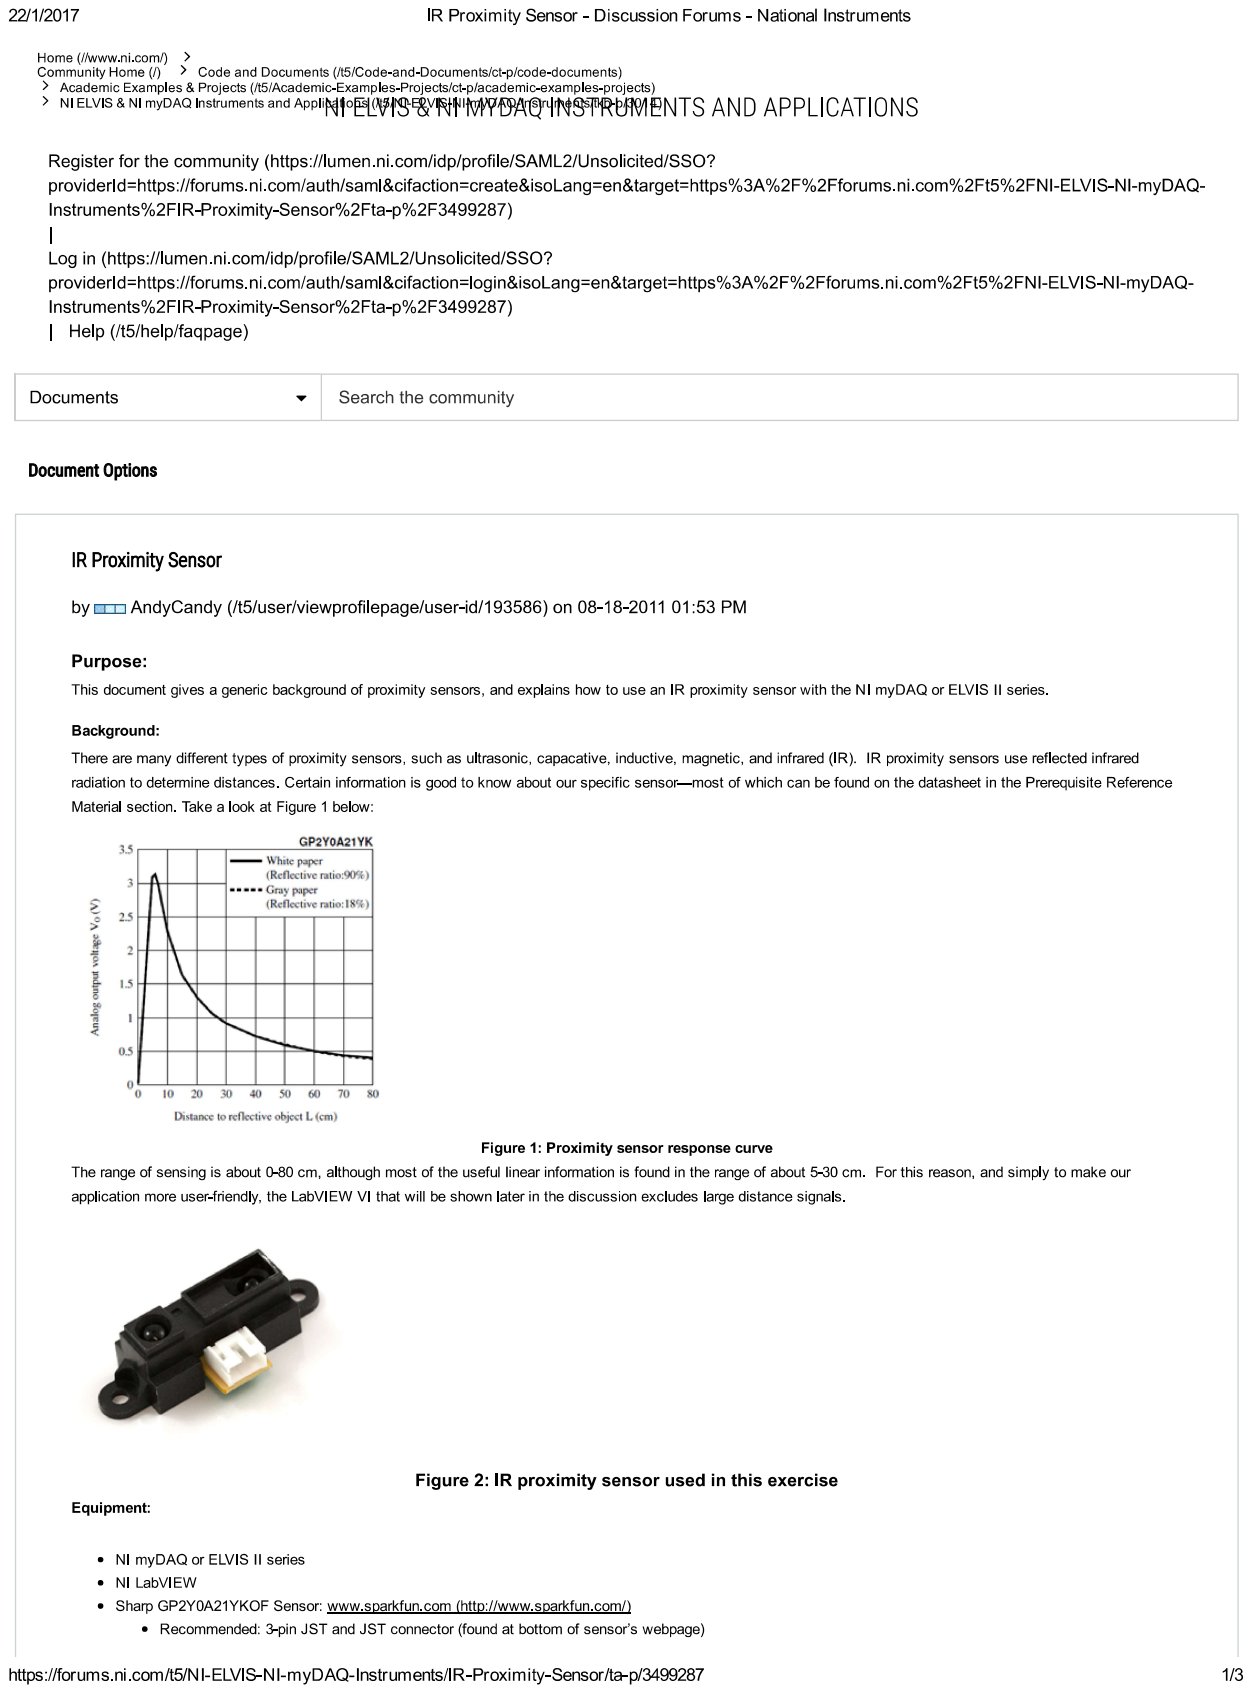
[picture p62: page 1]

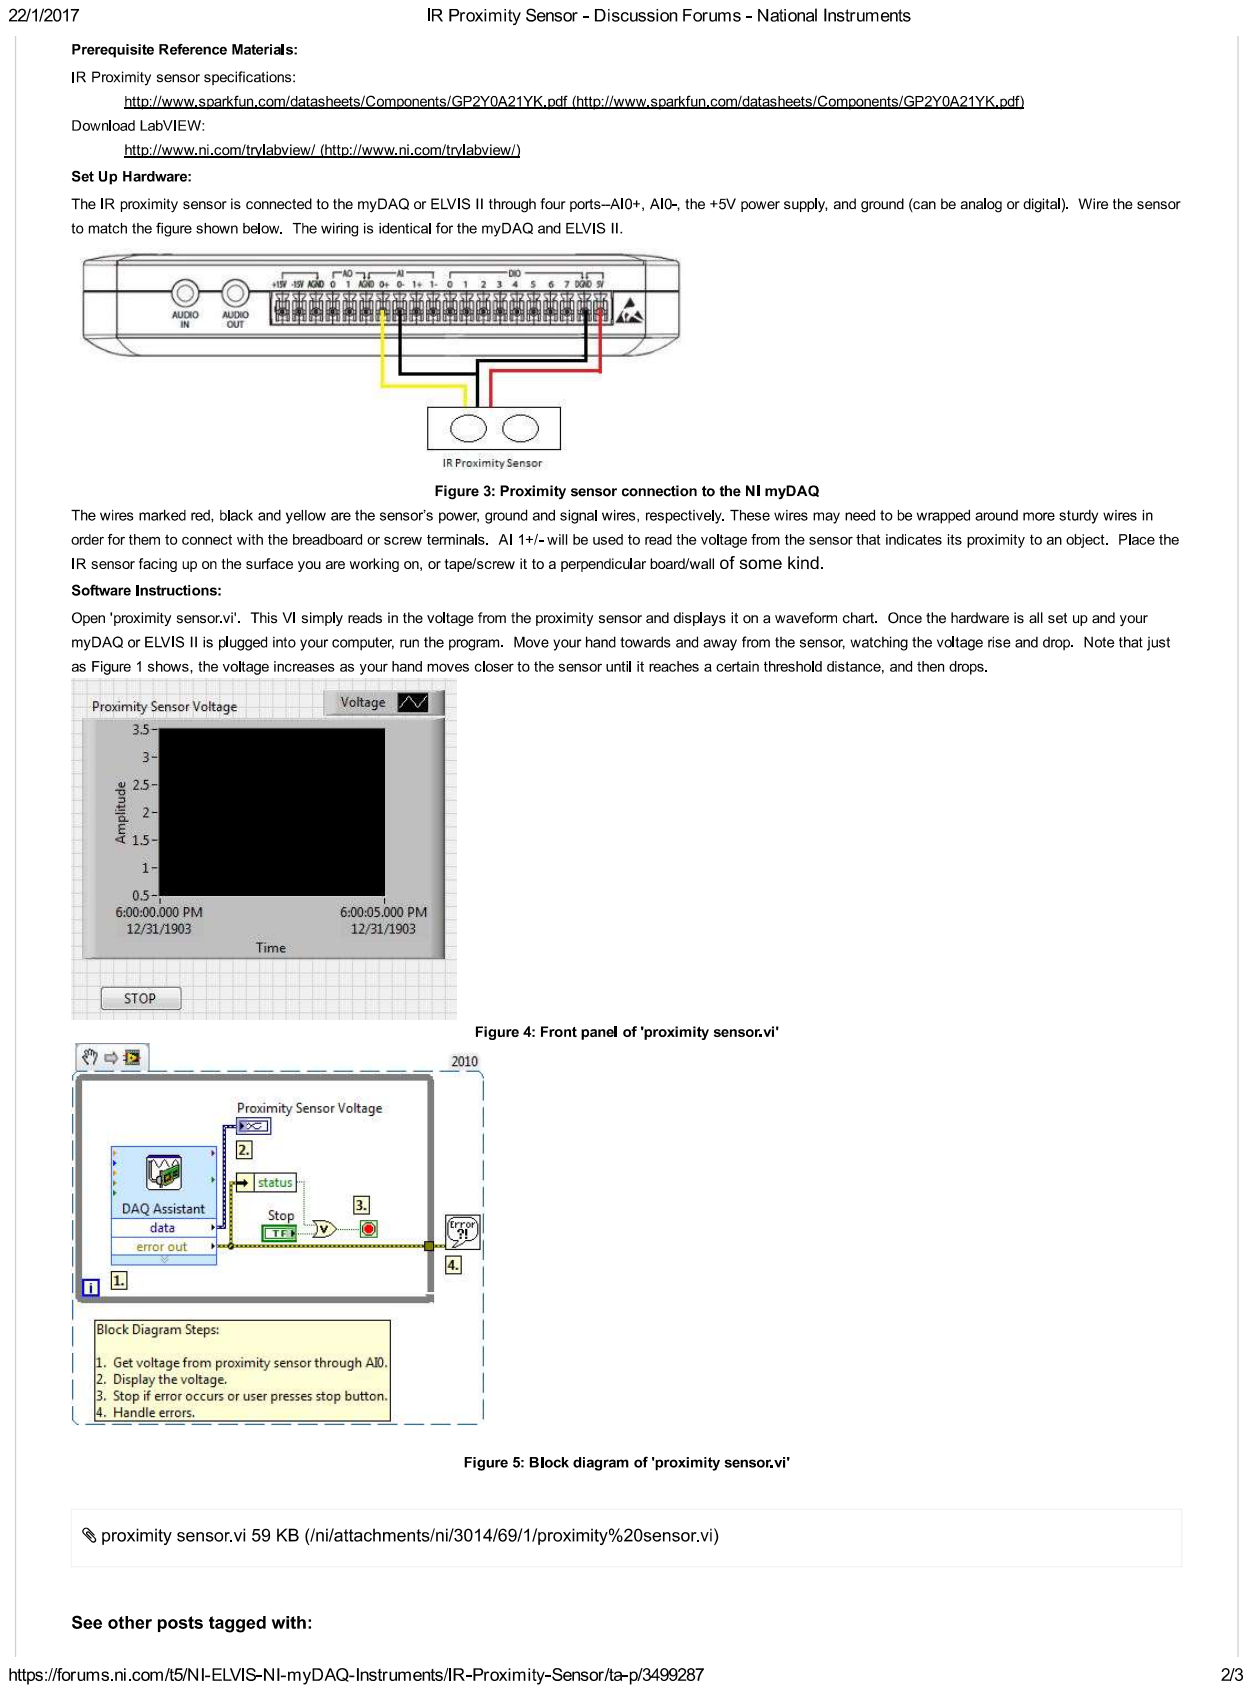
[picture p63: page 2]

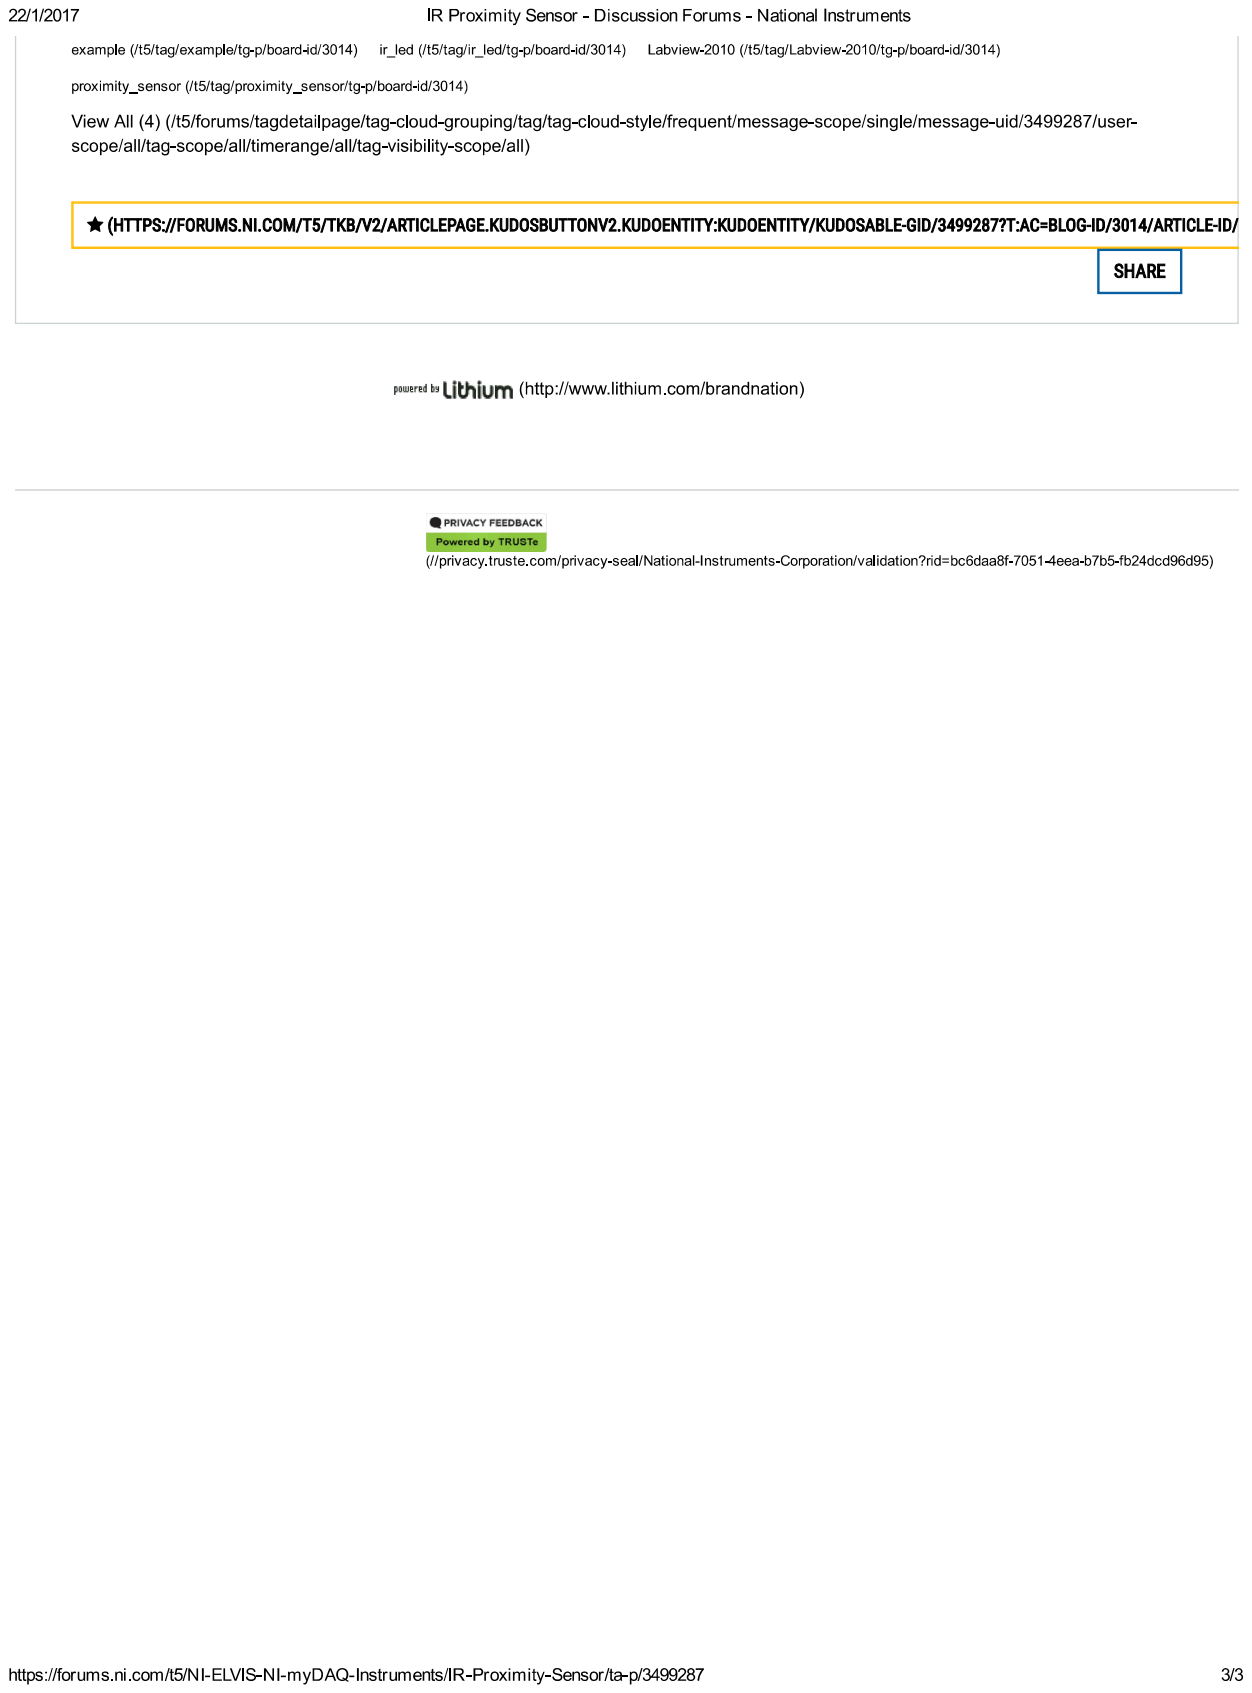
[picture p64: page 3]
