LPerezBustos/EC3883_AutomaticGuidedVehicle/(list of files, drawings)

Other design files:
circuits/GP2Y0A21YK_distance/schematics_proximity_sensor.ms14
circuits/TCRT1000_LineDetector/schematics_LineDetector_sensor.ms14
